EmbryoPhenomics/LabEmbryoCam_V2/software/assets/img/labec_instrument.png

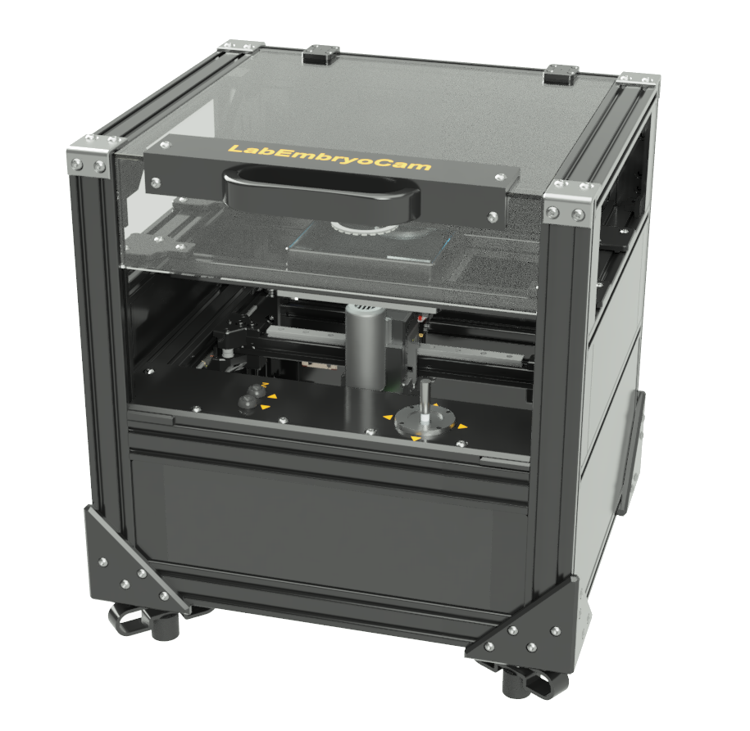
software/assets/img/labec_instrument.png
