EmbryoPhenomics/LabEmbryoCam_V2/hardware/STLs/humidification_chamber_main.stl

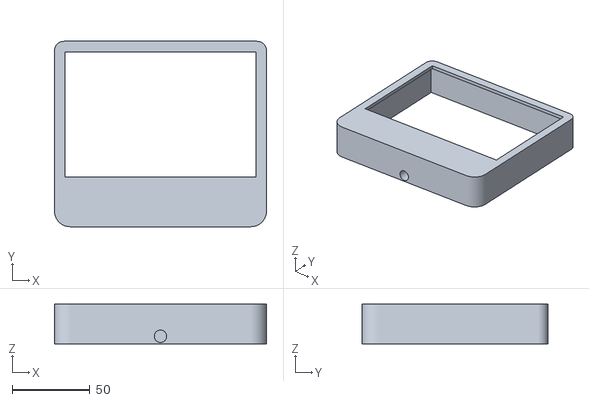
[picture p2: CAD file, 2023-06-20, last stored version]
hardware/STLs/humidification_chamber_main.stl
136.0 x 119.0 x 25.5
