EmbryoPhenomics/LabEmbryoCam_V2/hardware/STLs/z_carriage_assembly_light_insert.stl

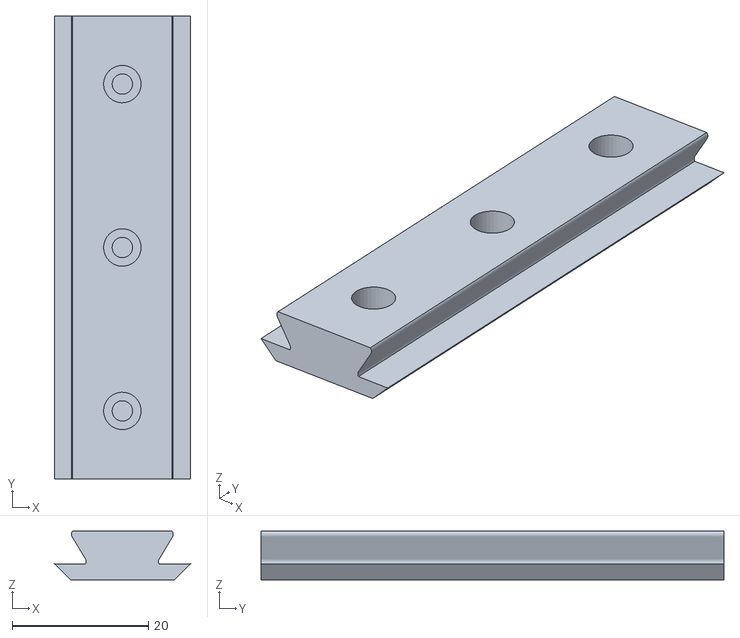
[picture p3: CAD file, 2023-06-20, last stored version]
hardware/STLs/z_carriage_assembly_light_insert.stl
20.0 x 68.0 x 7.16
