EmbryoPhenomics/LabEmbryoCam_V2/hardware/STLs/z_carriage_assembly_camera_tripod_adapter.stl

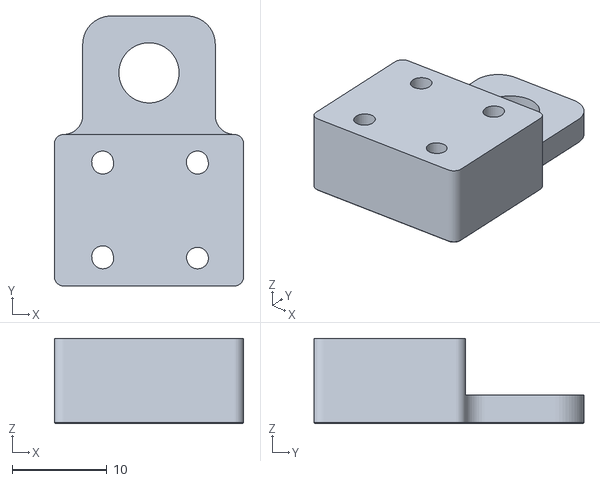
[picture p4: CAD file, 2023-06-20, last stored version]
hardware/STLs/z_carriage_assembly_camera_tripod_adapter.stl
20.0 x 28.5 x 9.00
