EmbryoPhenomics/LabEmbryoCam_V2/hardware/STLs/z_carriage_assembly_camera_mount.stl

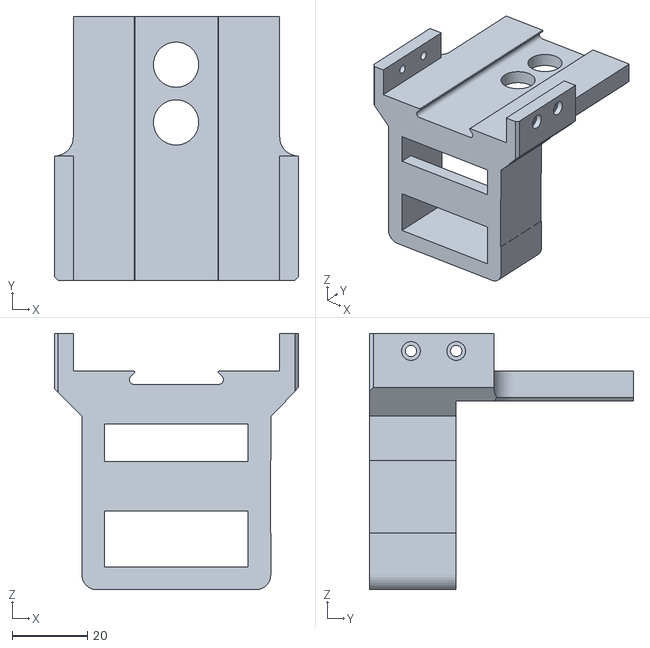
[picture p5: CAD file, 2023-06-20, last stored version]
hardware/STLs/z_carriage_assembly_camera_mount.stl
64.7 x 70.0 x 68.0
