EmbryoPhenomics/LabEmbryoCam_V2/hardware/STLs/z_carriage_assembly_optics_insert.stl

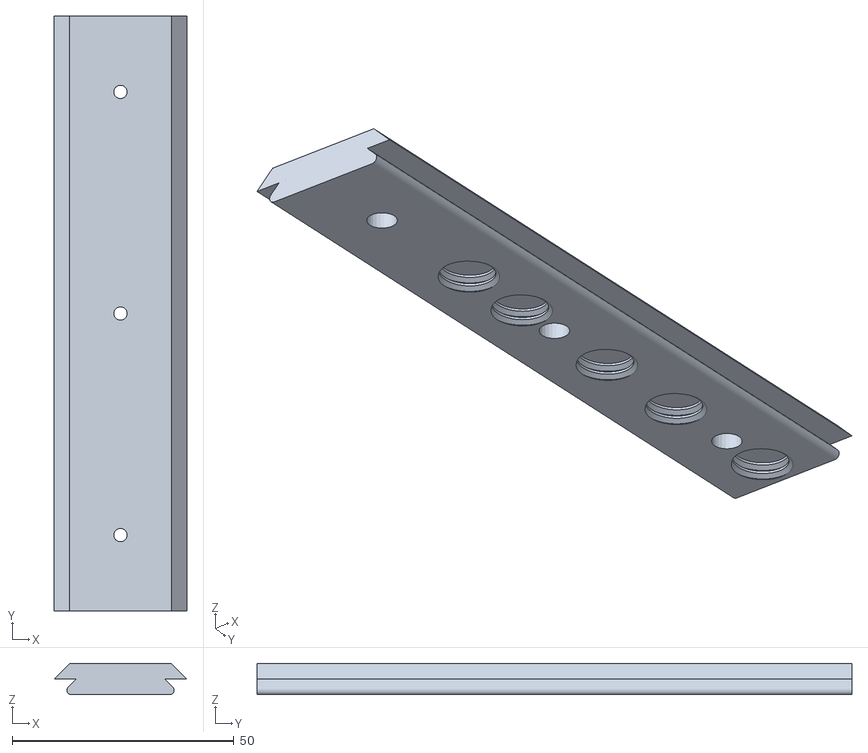
[picture p6: CAD file, 2023-06-20, last stored version]
hardware/STLs/z_carriage_assembly_optics_insert.stl
30.0 x 134.2 x 7.07
