EmbryoPhenomics/LabEmbryoCam_V2/hardware/STLs/back_motion_corner_mainbody_left.stl

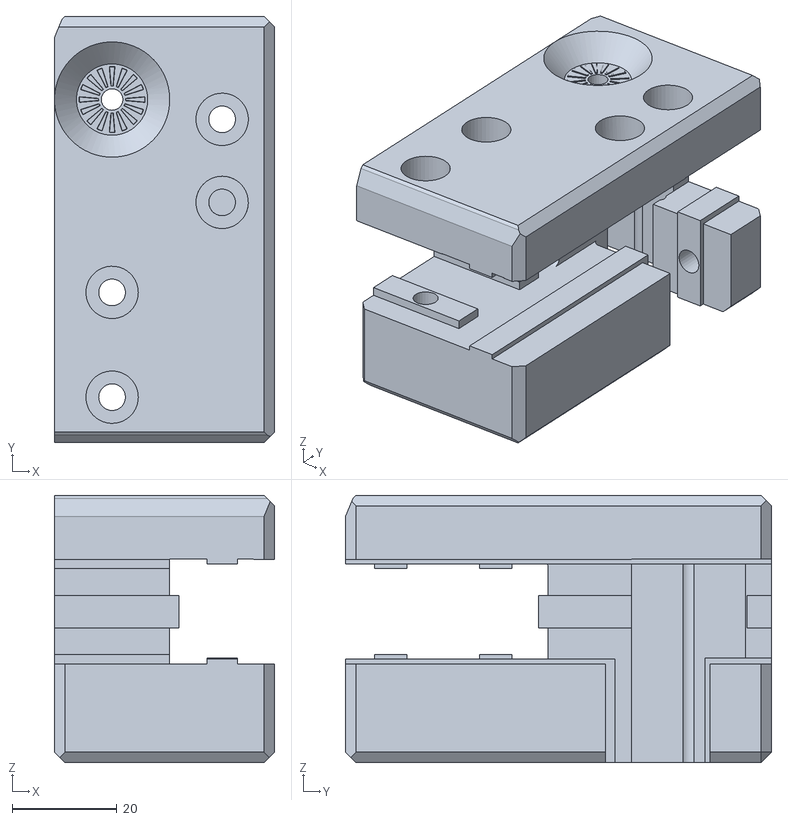
[picture p7: CAD file, 2023-06-20, last stored version]
hardware/STLs/back_motion_corner_mainbody_left.stl
42.0 x 81.3 x 51.0
