EmbryoPhenomics/LabEmbryoCam_V2/hardware/STLs/z_carriage_assembly_limit_trigger.stl

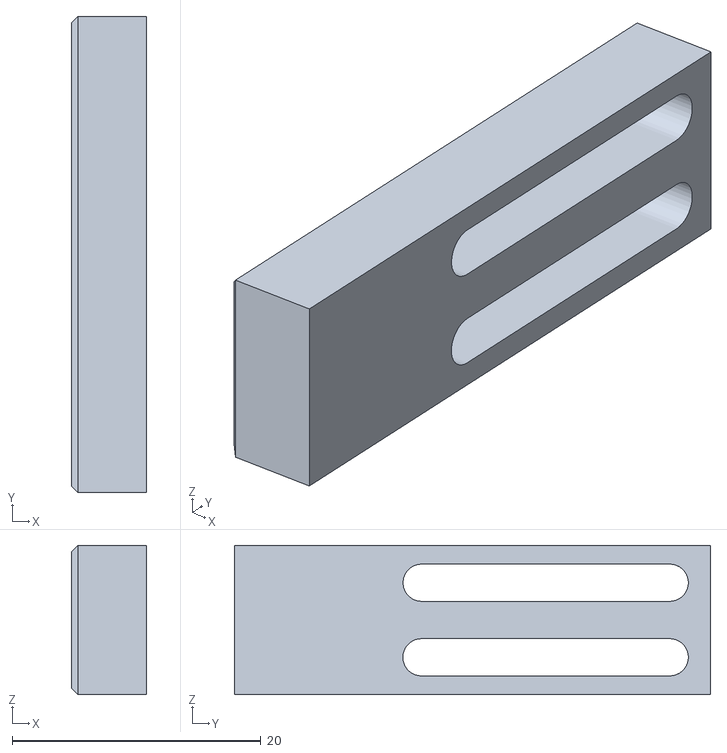
[picture p8: CAD file, 2023-06-20, last stored version]
hardware/STLs/z_carriage_assembly_limit_trigger.stl
6.00 x 38.3 x 12.0
