EmbryoPhenomics/LabEmbryoCam_V2/hardware/STLs/back_motion_corner_mainbody_right.stl

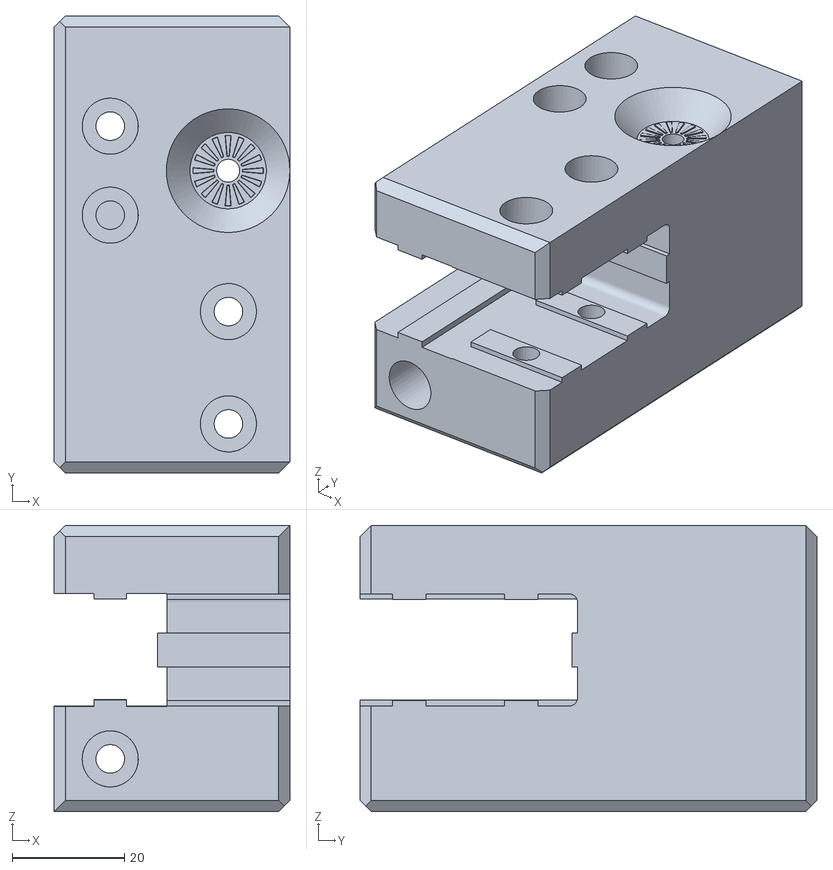
[picture p9: CAD file, 2023-06-20, last stored version]
hardware/STLs/back_motion_corner_mainbody_right.stl
42.0 x 81.4 x 51.0
