EmbryoPhenomics/LabEmbryoCam_V2/hardware/STLs/cable vibration dampener bottom.stl

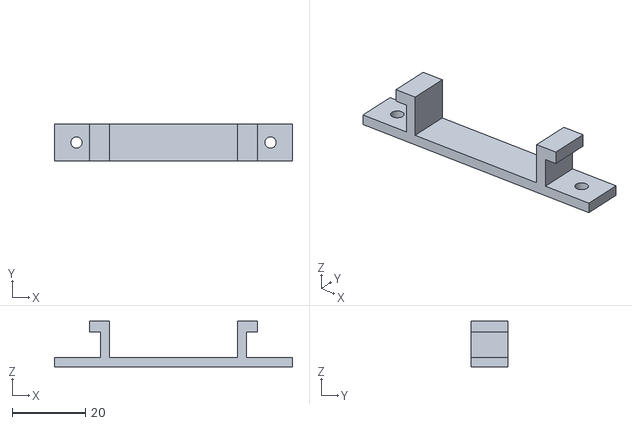
[picture p10: CAD file, 2023-06-20, last stored version]
hardware/STLs/cable vibration dampener bottom.stl
65.0 x 10.0 x 12.5
