EmbryoPhenomics/LabEmbryoCam_V2/hardware/STLs/humidification_chamber_lid.stl

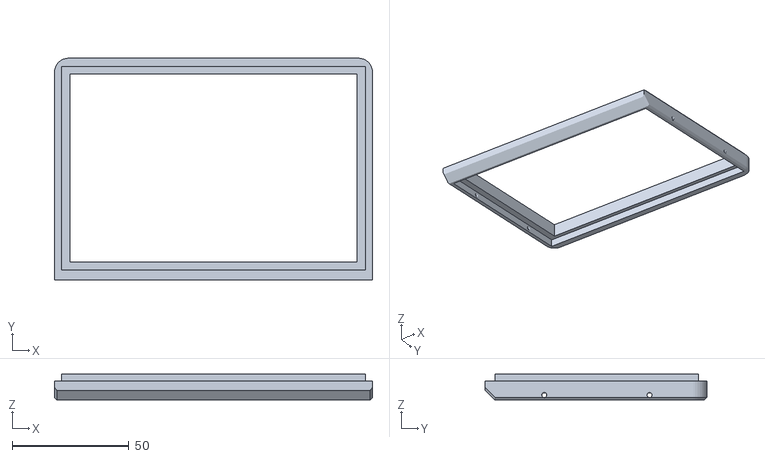
[picture p11: CAD file, 2023-06-20, last stored version]
hardware/STLs/humidification_chamber_lid.stl
136.0 x 94.8 x 11.0
