EmbryoPhenomics/LabEmbryoCam_V2/hardware/STLs/z_carriage_light_carrier.stl

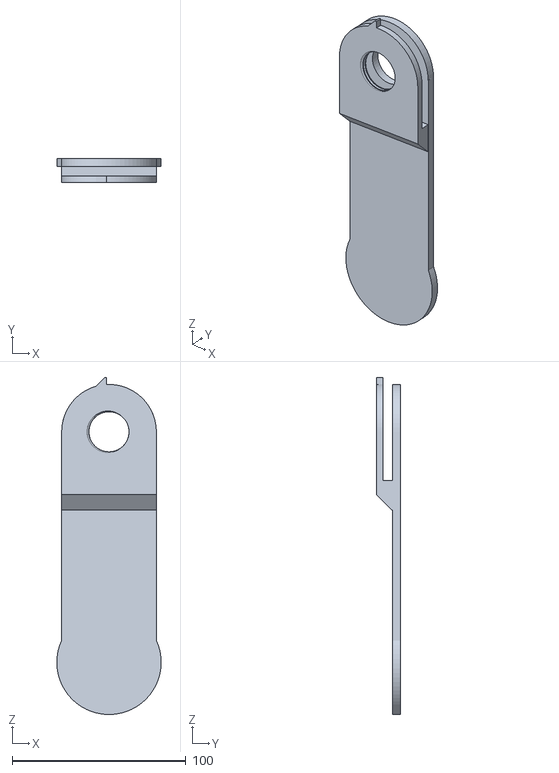
[picture p12: CAD file, 2023-06-20, last stored version]
hardware/STLs/z_carriage_light_carrier.stl
60.0 x 14.0 x 193.7
