EmbryoPhenomics/LabEmbryoCam_V2/hardware/STLs/z_carriage_light_slider.stl

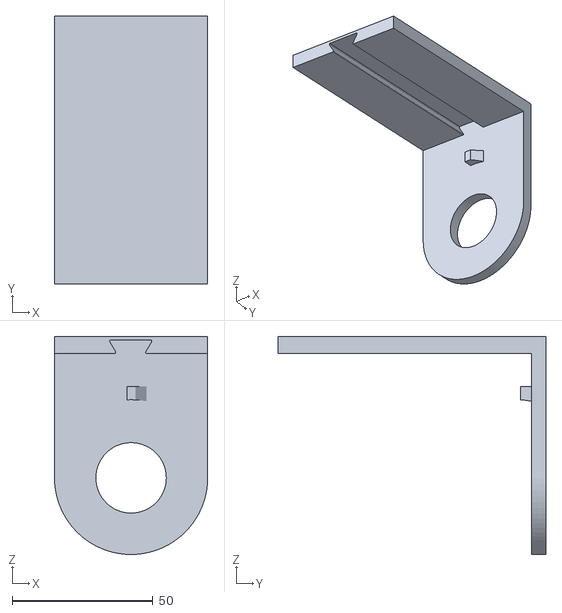
[picture p13: CAD file, 2023-06-20, last stored version]
hardware/STLs/z_carriage_light_slider.stl
54.5 x 95.0 x 77.4
