EmbryoPhenomics/LabEmbryoCam_V2/hardware/STLs/front_corner_left_bottom.stl

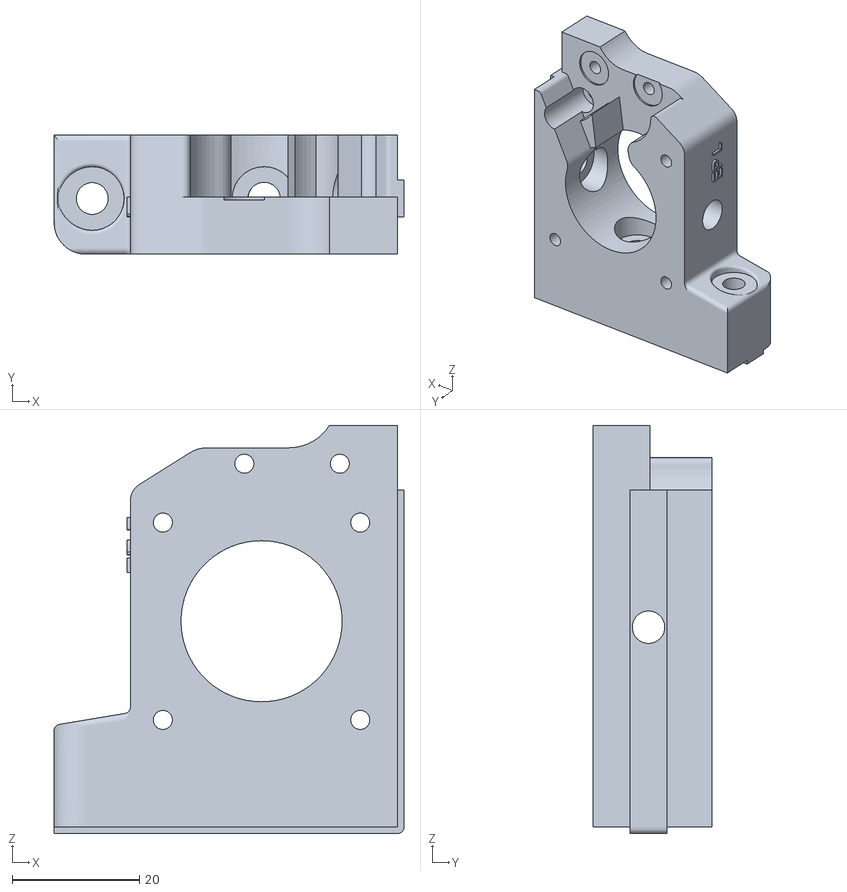
[picture p14: CAD file, 2023-06-20, last stored version]
hardware/STLs/front_corner_left_bottom.stl
55.0 x 18.8 x 64.1
