EmbryoPhenomics/LabEmbryoCam_V2/hardware/STLs/lid_bracket_support(2).stl

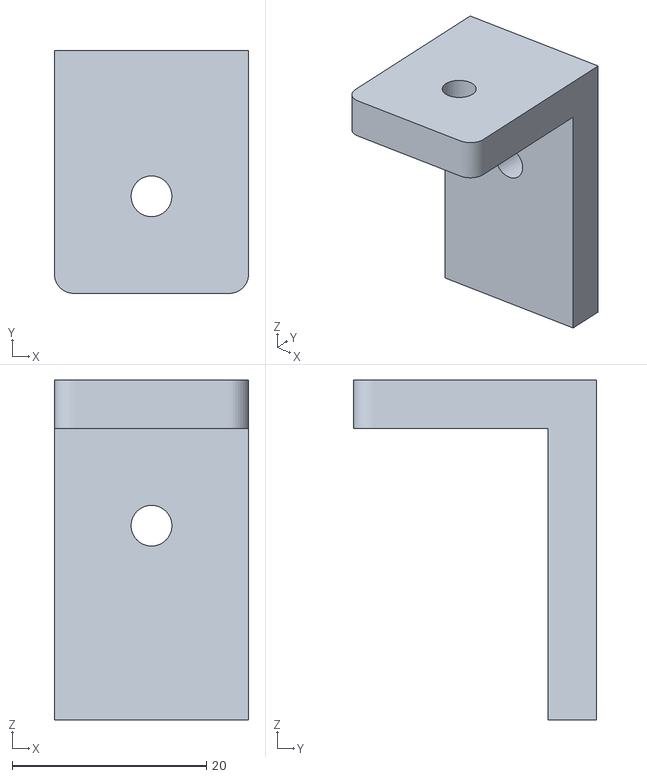
[picture p15: CAD file, 2023-06-20, last stored version]
hardware/STLs/lid_bracket_support(2).stl
20.0 x 25.0 x 35.0
