EmbryoPhenomics/LabEmbryoCam_V2/hardware/STLs/lid_support_bracket_upper.stl

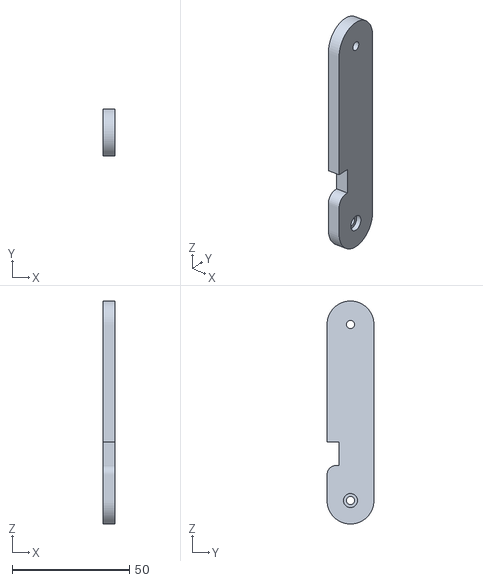
[picture p16: CAD file, 2023-06-20, last stored version]
hardware/STLs/lid_support_bracket_upper.stl
5.00 x 20.0 x 95.0
