EmbryoPhenomics/LabEmbryoCam_V2/hardware/STLs/electronics_minitronics_mounting_bracket.stl

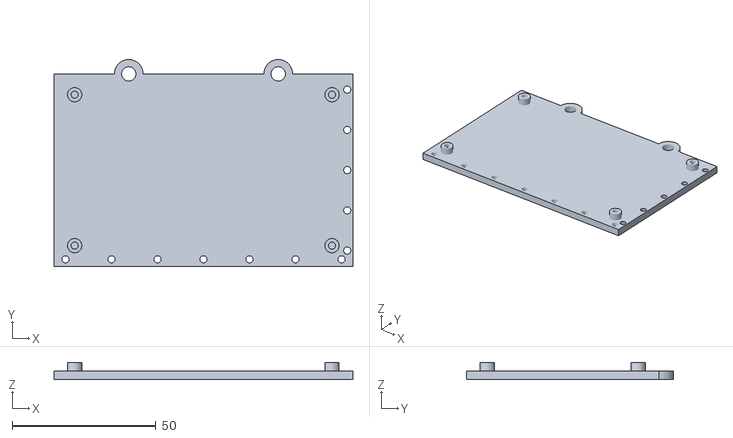
[picture p17: CAD file, 2023-06-20, last stored version]
hardware/STLs/electronics_minitronics_mounting_bracket.stl
104.0 x 72.0 x 6.00
