EmbryoPhenomics/LabEmbryoCam_V2/hardware/STLs/spacers_top_back_left.stl

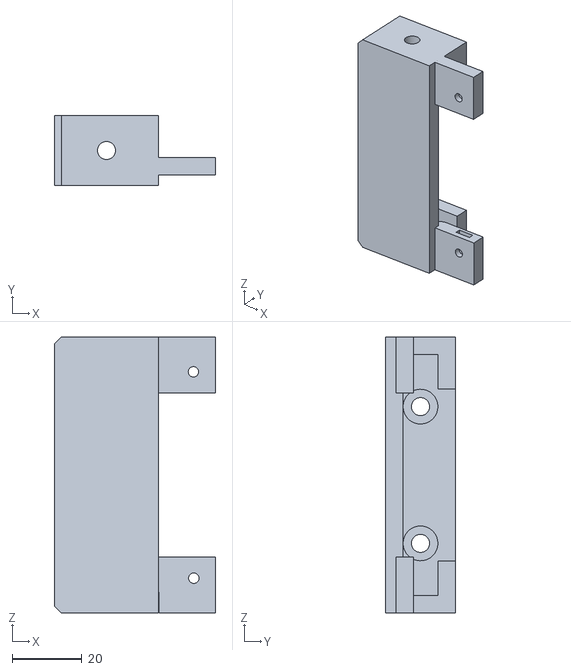
[picture p18: CAD file, 2023-06-20, last stored version]
hardware/STLs/spacers_top_back_left.stl
46.4 x 20.0 x 79.3
