EmbryoPhenomics/LabEmbryoCam_V2/hardware/STLs/y_mount_big_r.stl

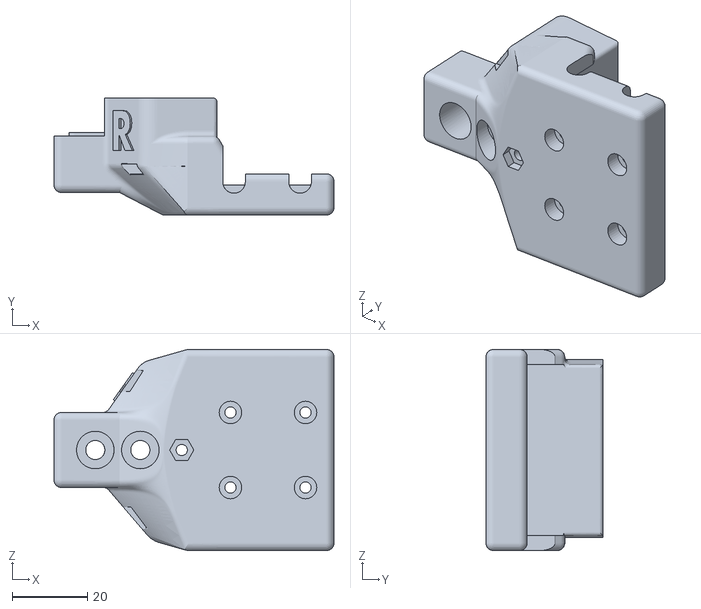
[picture p19: CAD file, 2023-06-20, last stored version]
hardware/STLs/y_mount_big_r.stl
74.6 x 31.2 x 53.6
