EmbryoPhenomics/LabEmbryoCam_V2/hardware/STLs/back_motion_corner_right_smallbody.stl

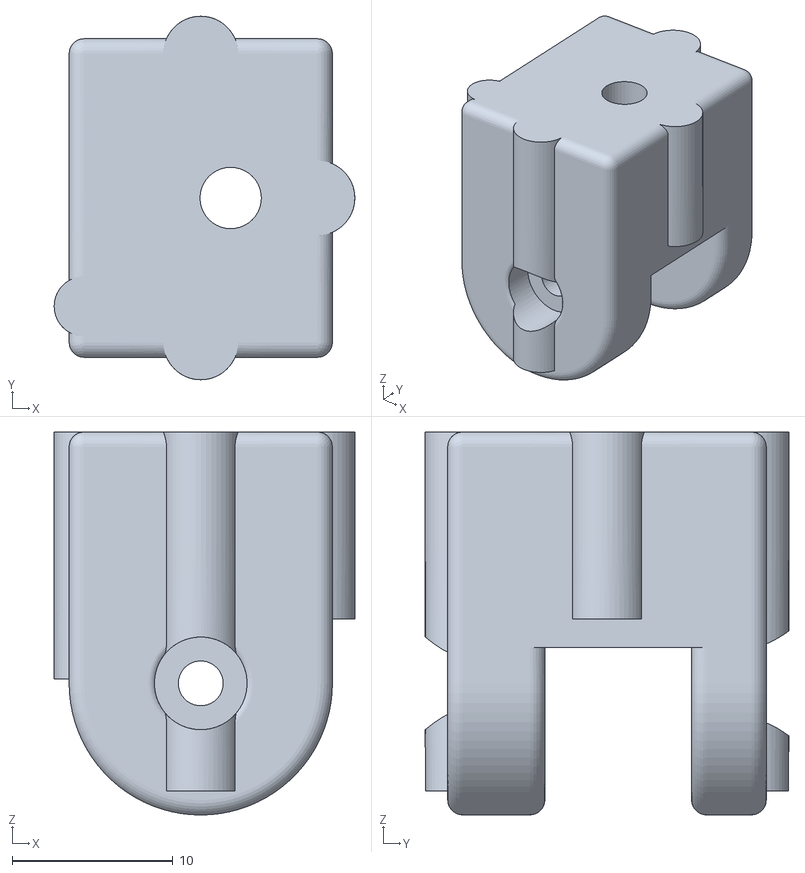
[picture p20: CAD file, 2023-06-20, last stored version]
hardware/STLs/back_motion_corner_right_smallbody.stl
18.7 x 22.6 x 23.8
