EmbryoPhenomics/LabEmbryoCam_V2/hardware/STLs/y_mount_small_r.stl

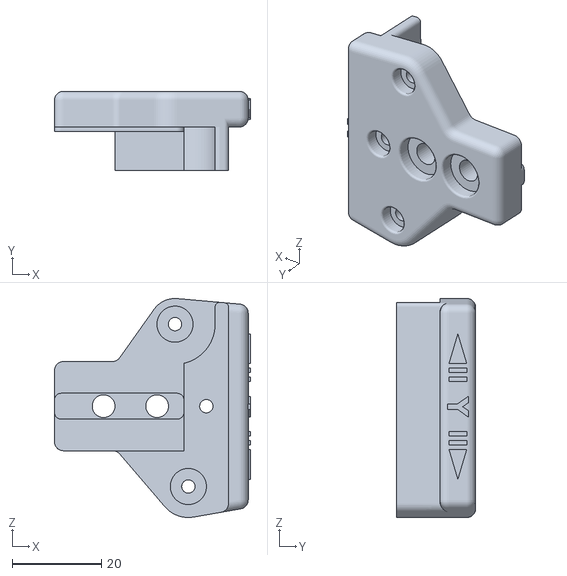
[picture p21: CAD file, 2023-06-20, last stored version]
hardware/STLs/y_mount_small_r.stl
43.9 x 17.8 x 49.1
