EmbryoPhenomics/LabEmbryoCam_V2/hardware/STLs/top_corner.stl

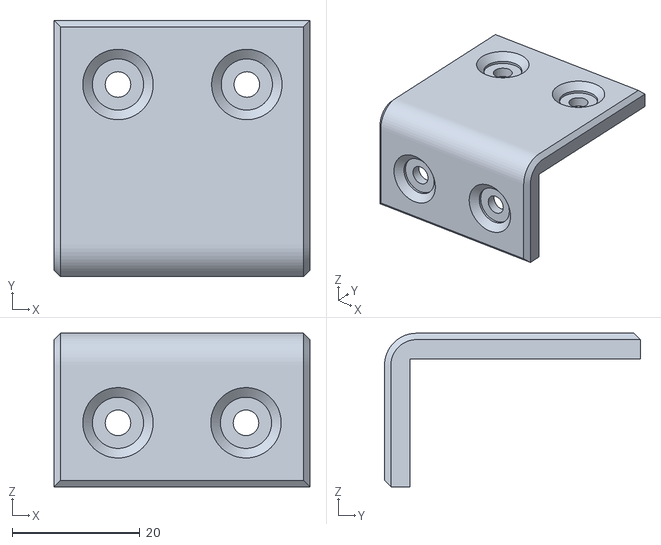
[picture p22: CAD file, 2023-06-20, last stored version]
hardware/STLs/top_corner.stl
40.0 x 40.0 x 24.0
