EmbryoPhenomics/LabEmbryoCam_V2/hardware/STLs/humidification_chamber_mount.stl

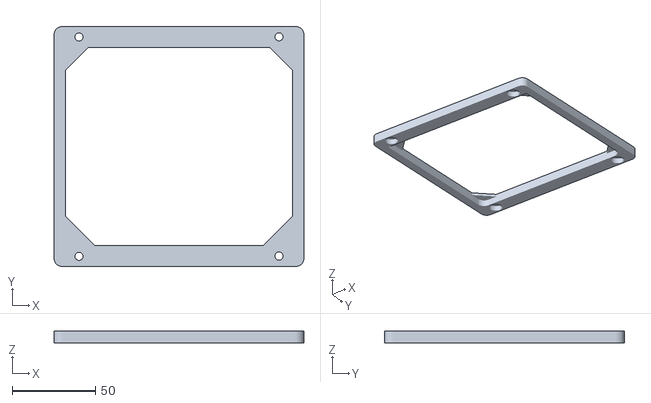
[picture p23: CAD file, 2023-06-20, last stored version]
hardware/STLs/humidification_chamber_mount.stl
150.0 x 144.0 x 7.00
