EmbryoPhenomics/LabEmbryoCam_V2/hardware/STLs/spacers_bottom_side_back_right.stl

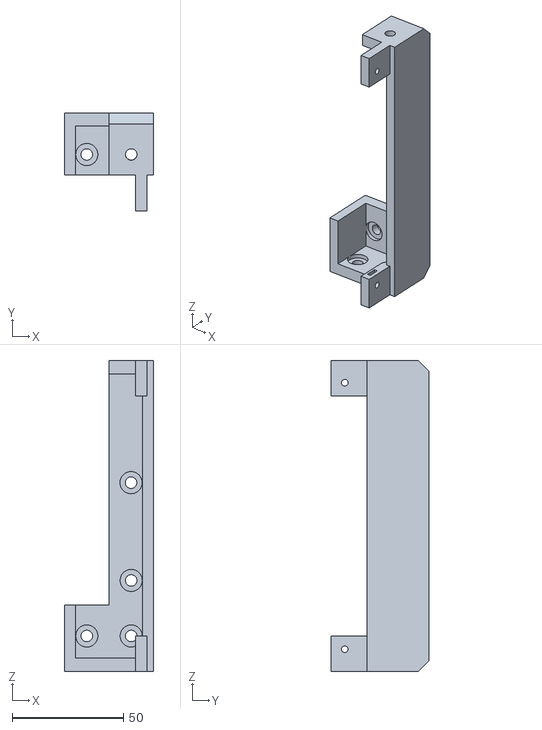
[picture p24: CAD file, 2023-06-20, last stored version]
hardware/STLs/spacers_bottom_side_back_right.stl
40.0 x 44.3 x 140.0
