EmbryoPhenomics/LabEmbryoCam_V2/hardware/STLs/front_corner_left_top.stl

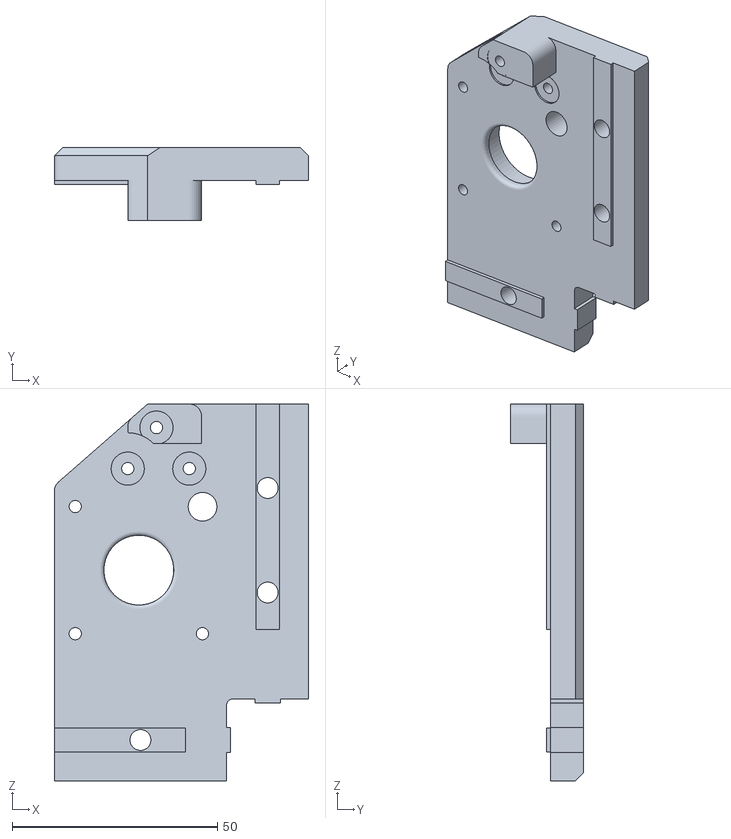
[picture p25: CAD file, 2023-06-20, last stored version]
hardware/STLs/front_corner_left_top.stl
62.0 x 17.8 x 91.9
