EmbryoPhenomics/LabEmbryoCam_V2/hardware/STLs/electronics_atx_power_mount.stl

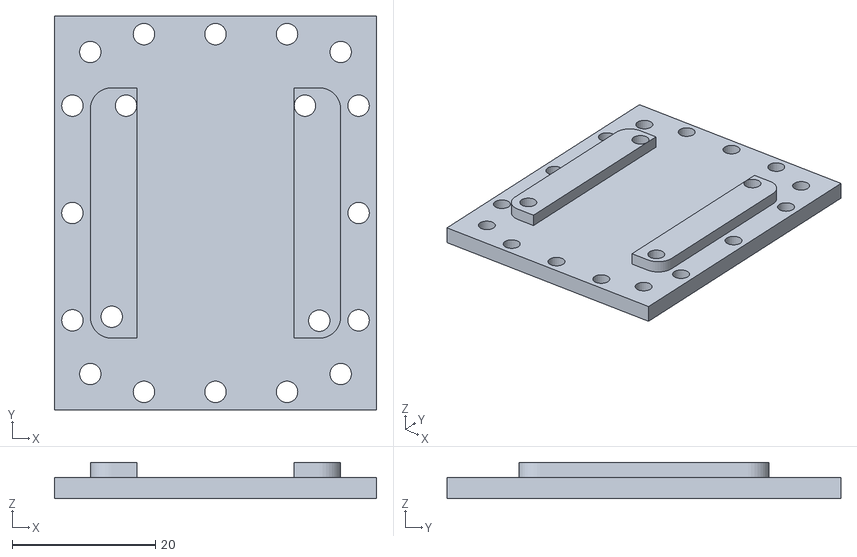
[picture p26: CAD file, 2023-06-20, last stored version]
hardware/STLs/electronics_atx_power_mount.stl
45.0 x 55.0 x 5.10
