EmbryoPhenomics/LabEmbryoCam_V2/hardware/STLs/lid_bracket.stl

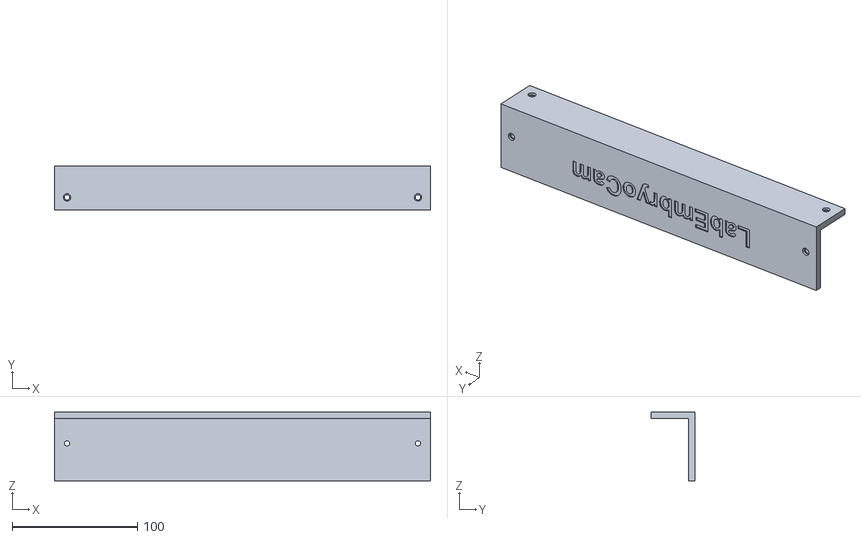
[picture p27: CAD file, 2023-06-20, last stored version]
hardware/STLs/lid_bracket.stl
300.0 x 35.0 x 55.0
