EmbryoPhenomics/LabEmbryoCam_V2/hardware/STLs/joystick_panel_right_Z_arrows.stl

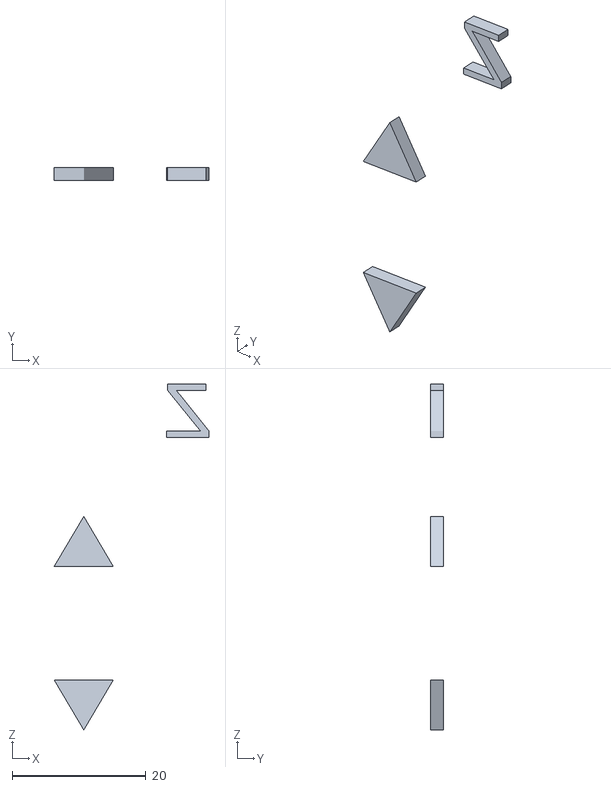
[picture p28: CAD file, 2023-06-20, last stored version]
hardware/STLs/joystick_panel_right_Z_arrows.stl
23.2 x 2.00 x 51.7
