EmbryoPhenomics/LabEmbryoCam_V2/hardware/STLs/spacers_bottom_back_right.stl

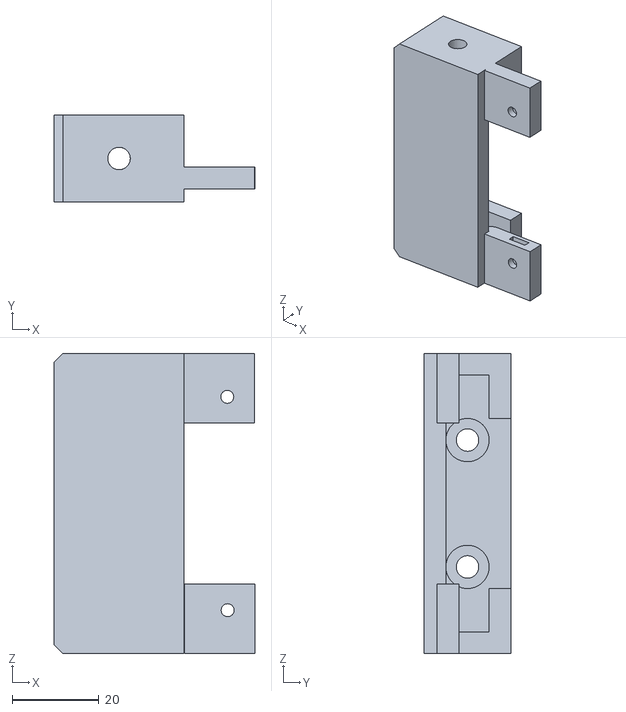
[picture p29: CAD file, 2023-06-20, last stored version]
hardware/STLs/spacers_bottom_back_right.stl
46.4 x 20.0 x 69.3
