EmbryoPhenomics/LabEmbryoCam_V2/hardware/STLs/back_corner_knob(2).stl

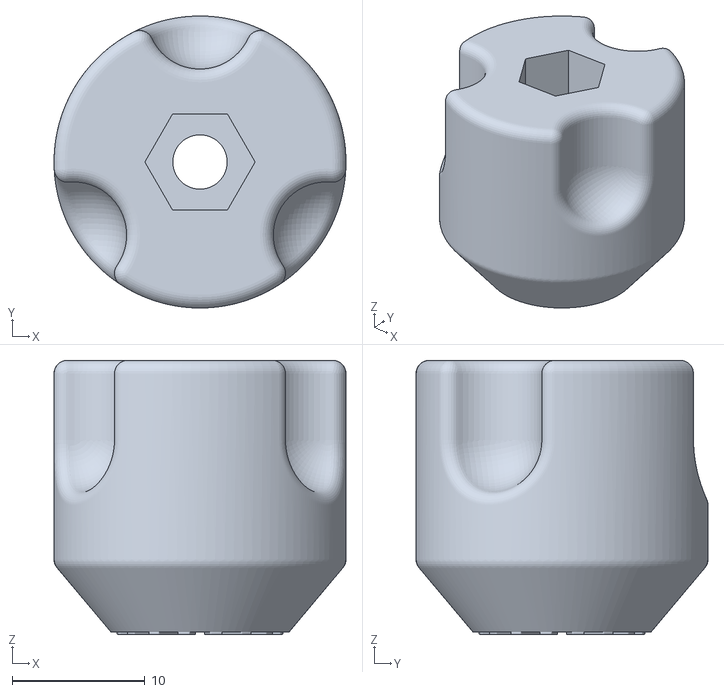
[picture p30: CAD file, 2023-06-20, last stored version]
hardware/STLs/back_corner_knob(2).stl
22.0 x 22.0 x 20.7
