EmbryoPhenomics/LabEmbryoCam_V2/hardware/STLs/sample_holder_bracket(4).stl

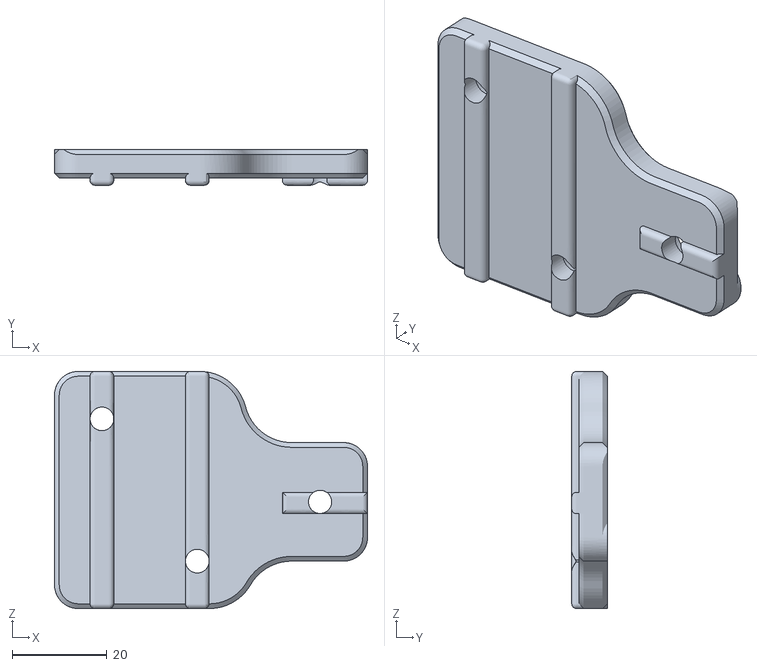
[picture p31: CAD file, 2023-06-20, last stored version]
hardware/STLs/sample_holder_bracket(4).stl
66.0 x 7.50 x 50.0
