EmbryoPhenomics/LabEmbryoCam_V2/hardware/STLs/electronics_minitronics_fan fan_support(mirror)(2).stl

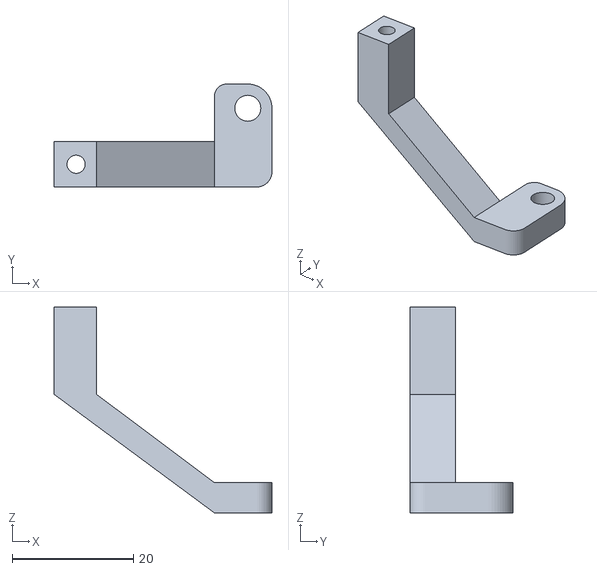
[picture p32: CAD file, 2023-06-20, last stored version]
hardware/STLs/electronics_minitronics_fan fan_support(mirror)(2).stl
36.0 x 17.0 x 34.0
