EmbryoPhenomics/LabEmbryoCam_V2/hardware/STLs/bottom_corner_bracket_mirror(2).stl

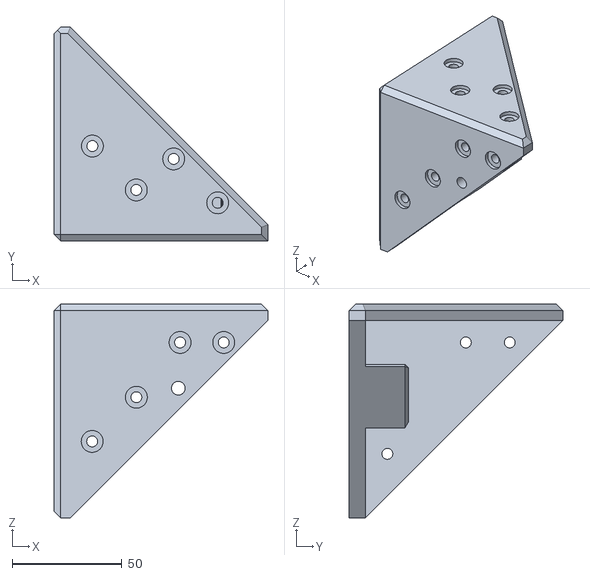
[picture p33: CAD file, 2023-06-20, last stored version]
hardware/STLs/bottom_corner_bracket_mirror(2).stl
97.5 x 97.5 x 97.5
