EmbryoPhenomics/LabEmbryoCam_V2/hardware/STLs/spacers_back_mid(2).stl

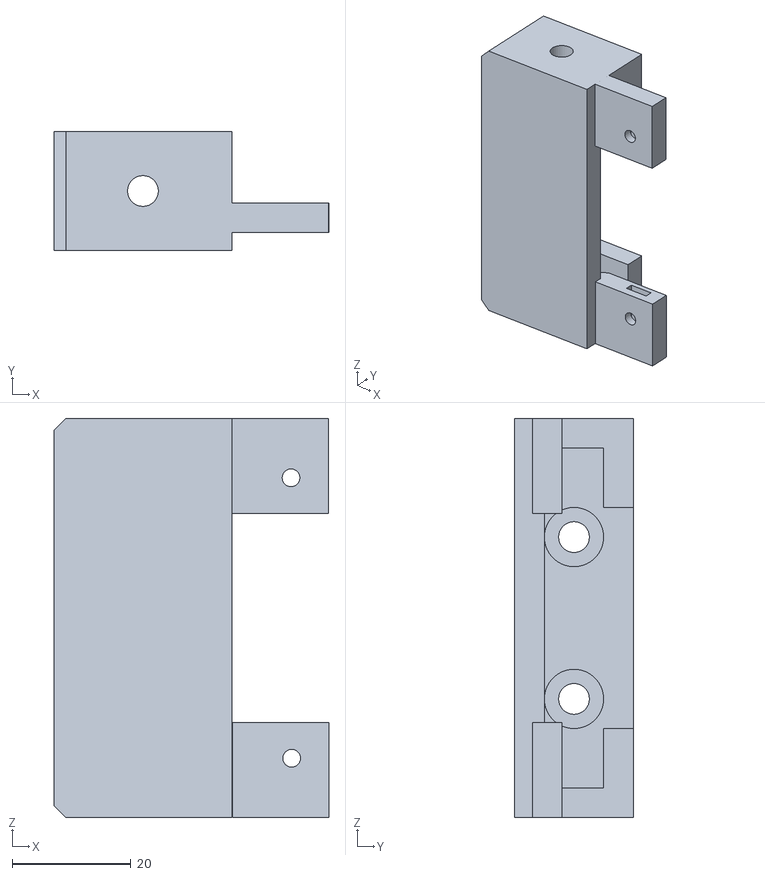
[picture p34: CAD file, 2023-06-20, last stored version]
hardware/STLs/spacers_back_mid(2).stl
46.4 x 20.0 x 67.3
