EmbryoPhenomics/LabEmbryoCam_V2/hardware/STLs/spacers_front_bottom_right.stl

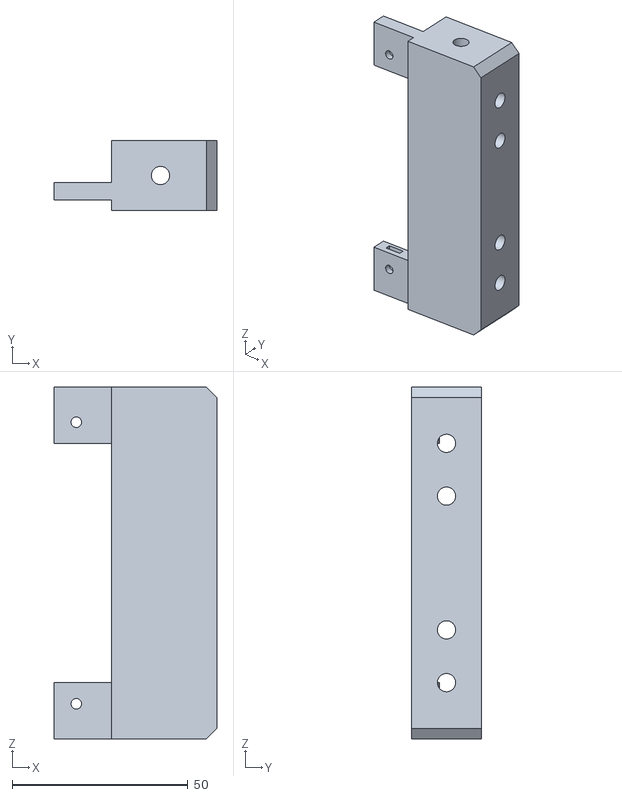
[picture p35: CAD file, 2023-06-20, last stored version]
hardware/STLs/spacers_front_bottom_right.stl
46.2 x 20.0 x 100.0
