EmbryoPhenomics/LabEmbryoCam_V2/hardware/STLs/spacers_mid_and_top_bracket(4).stl

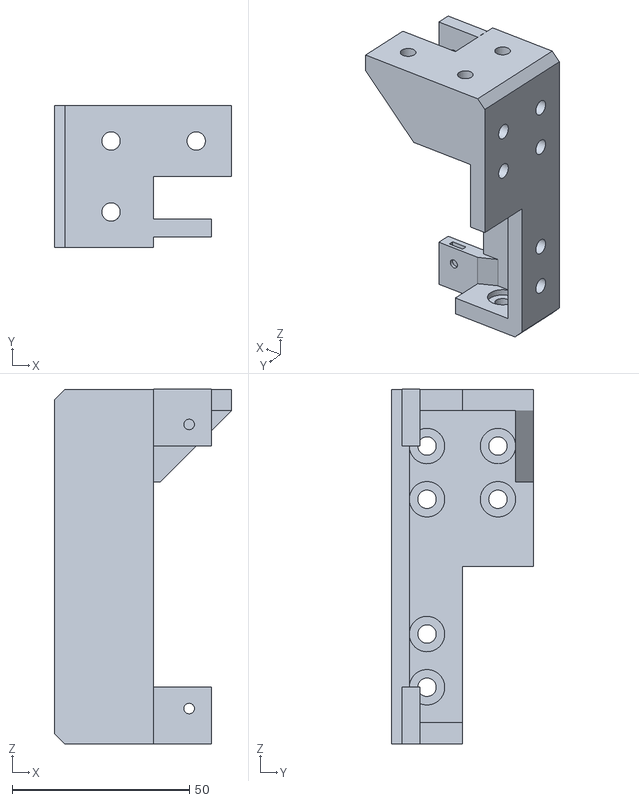
[picture p36: CAD file, 2023-06-20, last stored version]
hardware/STLs/spacers_mid_and_top_bracket(4).stl
50.0 x 40.0 x 100.1
