EmbryoPhenomics/LabEmbryoCam_V2/hardware/STLs/joystick_panel_left.stl

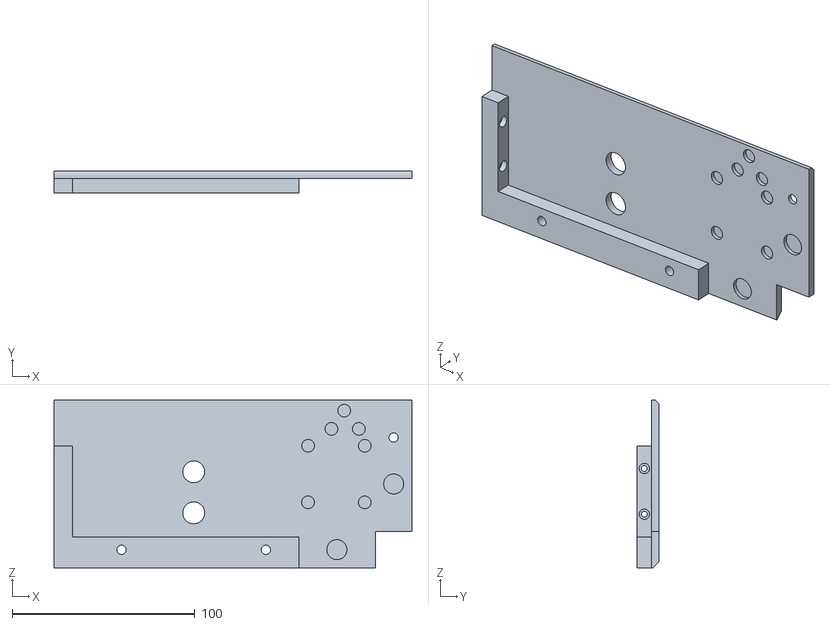
[picture p37: CAD file, 2023-06-20, last stored version]
hardware/STLs/joystick_panel_left.stl
196.0 x 12.0 x 92.0
