EmbryoPhenomics/LabEmbryoCam_V2/hardware/STLs/front_corner_left_bottom_small.stl

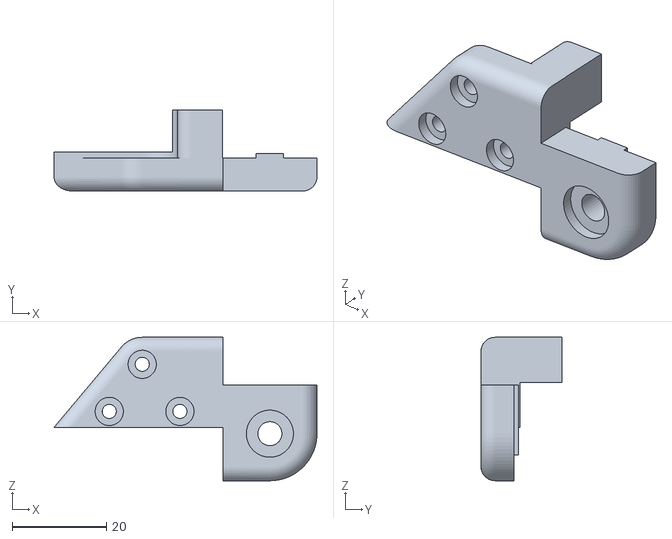
[picture p38: CAD file, 2023-06-20, last stored version]
hardware/STLs/front_corner_left_bottom_small.stl
55.8 x 17.2 x 30.5
