EmbryoPhenomics/LabEmbryoCam_V2/hardware/STLs/electronics_raspberry_pi_mount.stl

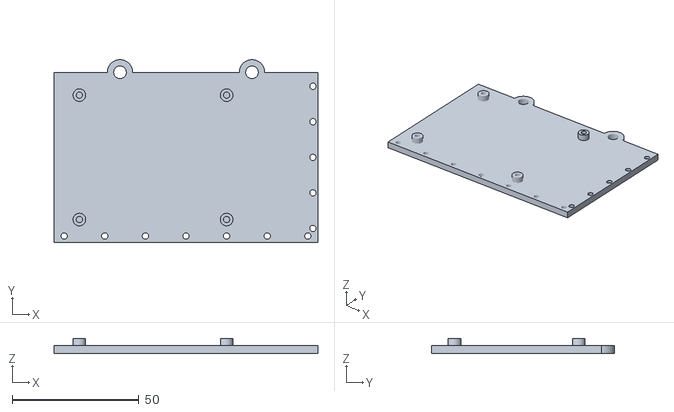
[picture p39: CAD file, 2023-06-20, last stored version]
hardware/STLs/electronics_raspberry_pi_mount.stl
104.0 x 72.0 x 5.79
