EmbryoPhenomics/LabEmbryoCam_V2/hardware/STLs/joystick_panel_left_XY_arrows.stl

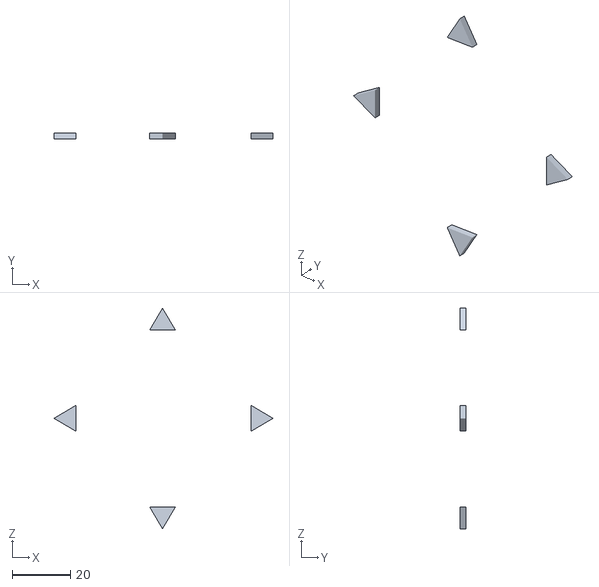
[picture p40: CAD file, 2023-06-20, last stored version]
hardware/STLs/joystick_panel_left_XY_arrows.stl
75.1 x 2.00 x 75.7
