EmbryoPhenomics/LabEmbryoCam_V2/hardware/STLs/z_carriage_rail_mount_insert.stl

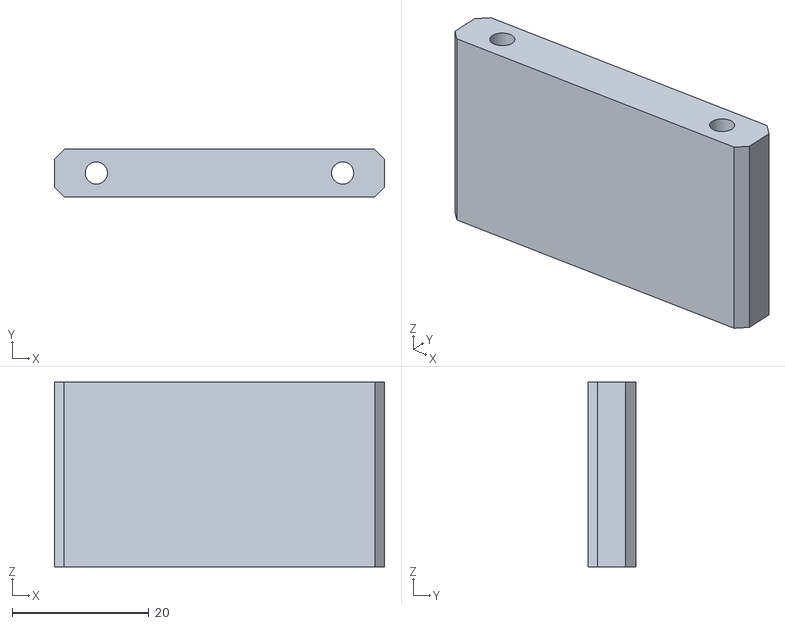
[picture p41: CAD file, 2023-06-20, last stored version]
hardware/STLs/z_carriage_rail_mount_insert.stl
48.2 x 7.00 x 27.0
