EmbryoPhenomics/LabEmbryoCam_V2/hardware/STLs/feet_leafspring(4).stl

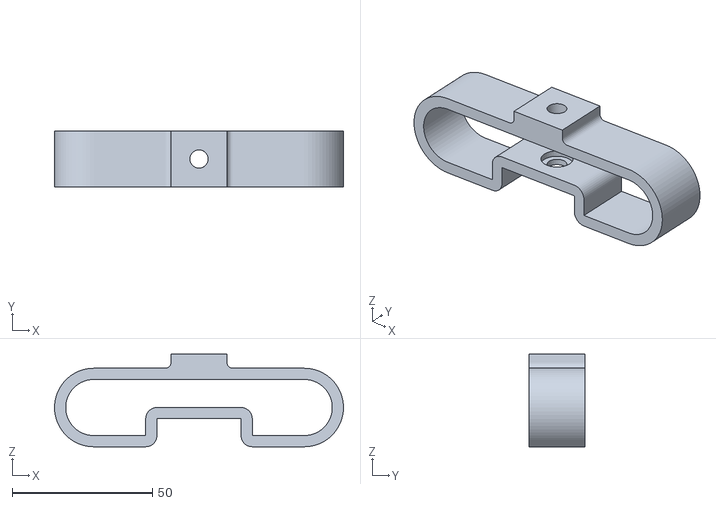
[picture p42: CAD file, 2023-06-20, last stored version]
hardware/STLs/feet_leafspring(4).stl
103.0 x 20.0 x 33.0
