EmbryoPhenomics/LabEmbryoCam_V2/hardware/STLs/lid_bracket_text.stl

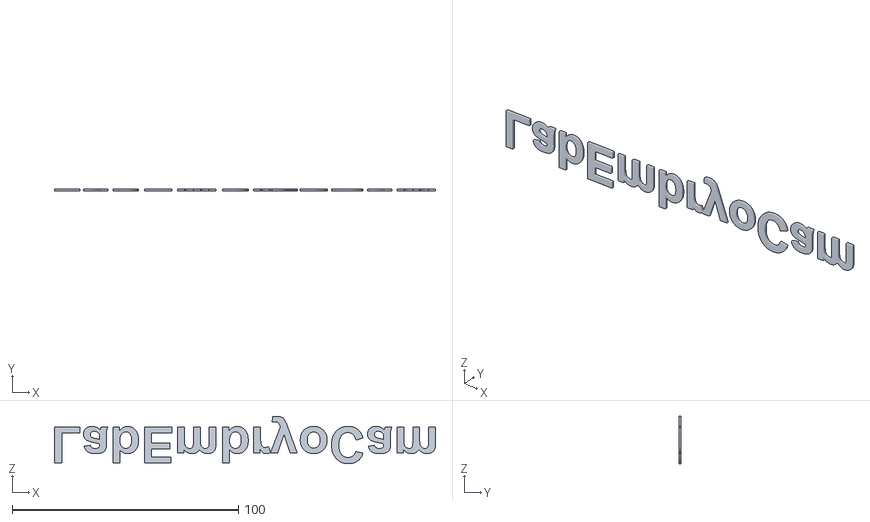
[picture p43: CAD file, 2023-06-20, last stored version]
hardware/STLs/lid_bracket_text.stl
168.2 x 1.00 x 21.0
