EmbryoPhenomics/LabEmbryoCam_V2/hardware/STLs/lid_support_bracket_pivot(2).stl

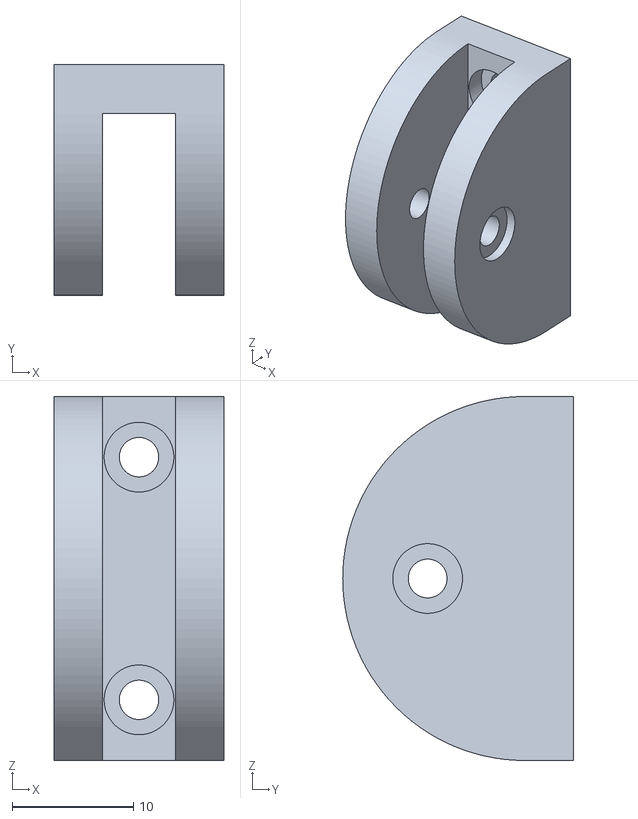
[picture p44: CAD file, 2023-06-20, last stored version]
hardware/STLs/lid_support_bracket_pivot(2).stl
14.0 x 19.0 x 30.0
