EmbryoPhenomics/LabEmbryoCam_V2/hardware/STLs/front_corner_right_top.stl

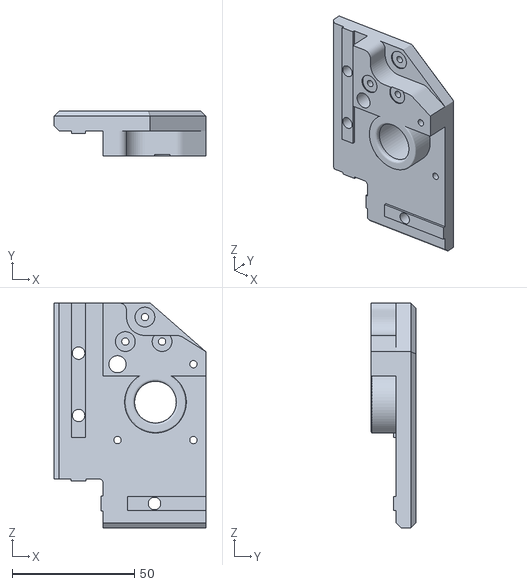
[picture p45: CAD file, 2023-06-20, last stored version]
hardware/STLs/front_corner_right_top.stl
62.0 x 18.2 x 91.9
