EmbryoPhenomics/LabEmbryoCam_V2/hardware/STLs/lid_handle.stl

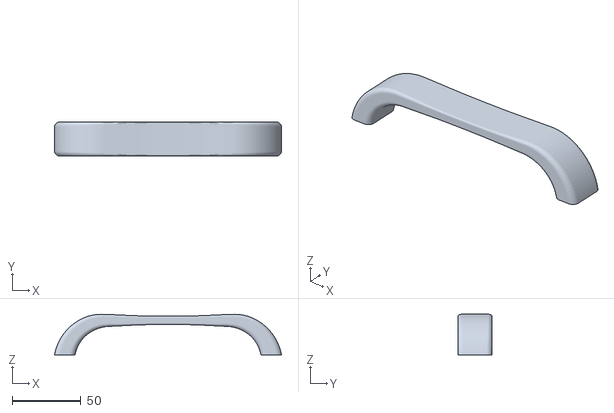
[picture p46: CAD file, 2023-06-20, last stored version]
hardware/STLs/lid_handle.stl
165.0 x 25.0 x 29.4
