EmbryoPhenomics/LabEmbryoCam_V2/hardware/STLs/z_carriage_rail_mount.stl

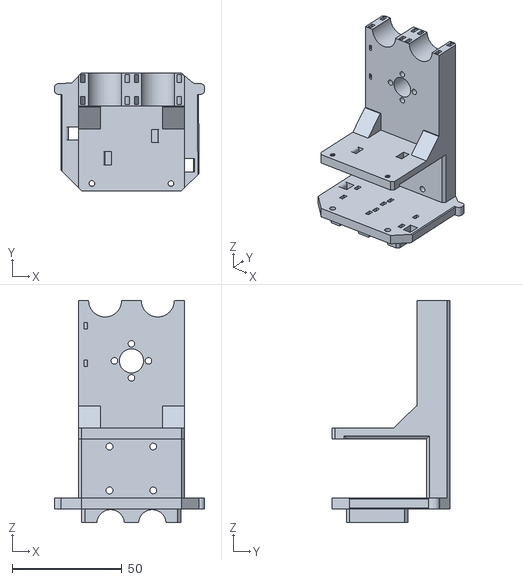
[picture p47: CAD file, 2023-06-20, last stored version]
hardware/STLs/z_carriage_rail_mount.stl
68.5 x 53.8 x 101.1
