EmbryoPhenomics/LabEmbryoCam_V2/hardware/STLs/electronics_dual_arduino_mount_extended.stl

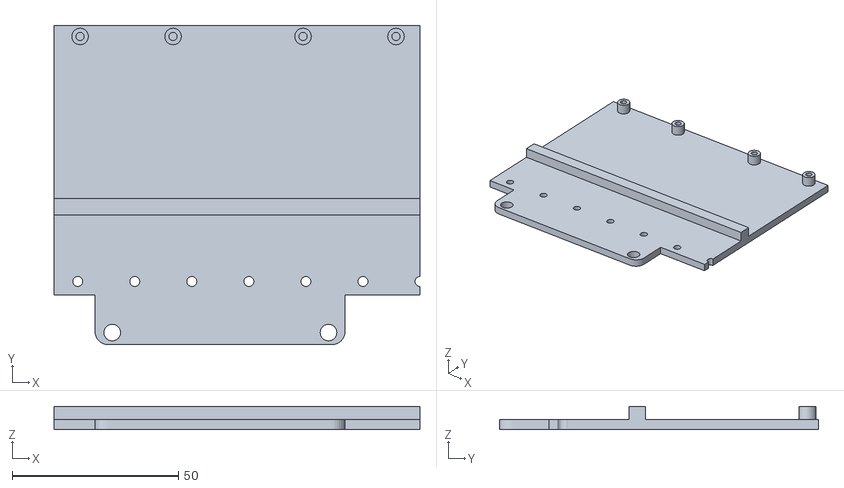
[picture p48: CAD file, 2023-06-20, last stored version]
hardware/STLs/electronics_dual_arduino_mount_extended.stl
110.0 x 96.0 x 7.00
