EmbryoPhenomics/LabEmbryoCam_V2/hardware/STLs/front_corner_right_bottom.stl

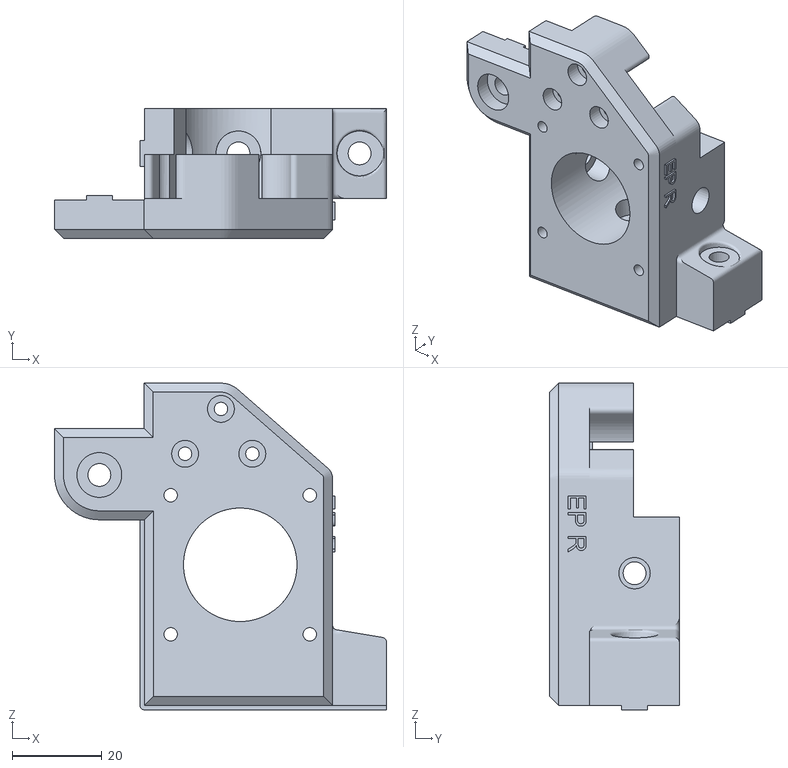
[picture p49: CAD file, 2023-06-20, last stored version]
hardware/STLs/front_corner_right_bottom.stl
74.0 x 29.0 x 72.8
