EmbryoPhenomics/LabEmbryoCam_V2/hardware/STLs/lid_support_bracket_lower.stl

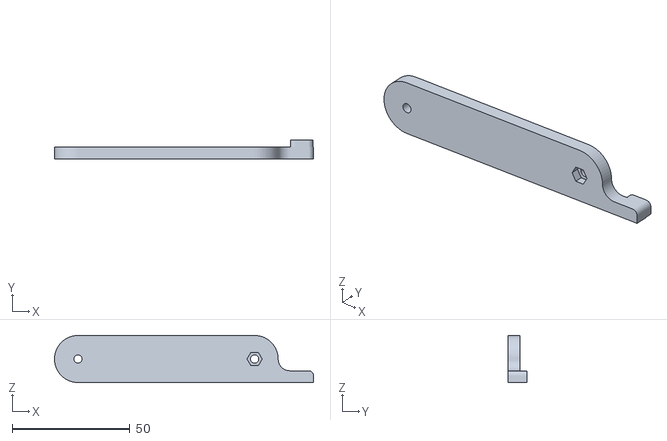
[picture p50: CAD file, 2023-06-20, last stored version]
hardware/STLs/lid_support_bracket_lower.stl
110.0 x 8.00 x 20.0
