EmbryoPhenomics/LabEmbryoCam_V2/hardware/STLs/bottom_corner_bracket(2).stl

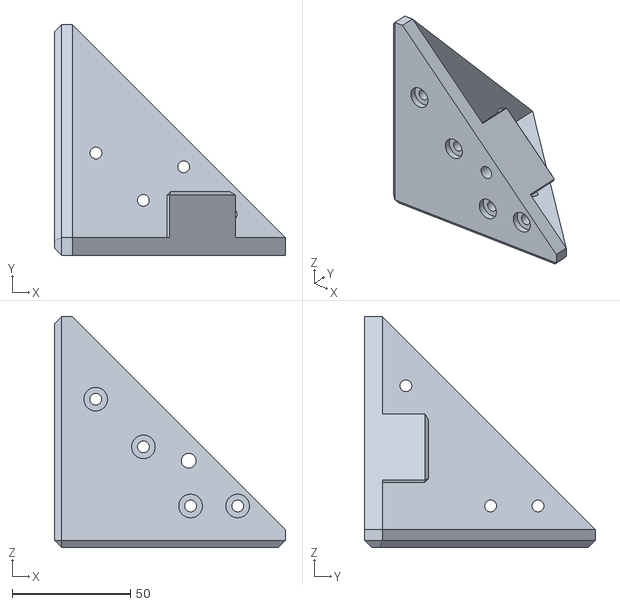
[picture p51: CAD file, 2023-06-20, last stored version]
hardware/STLs/bottom_corner_bracket(2).stl
97.5 x 97.5 x 97.5
