EmbryoPhenomics/LabEmbryoCam_V2/hardware/STLs/back_motion_corner_left_smallbody.stl

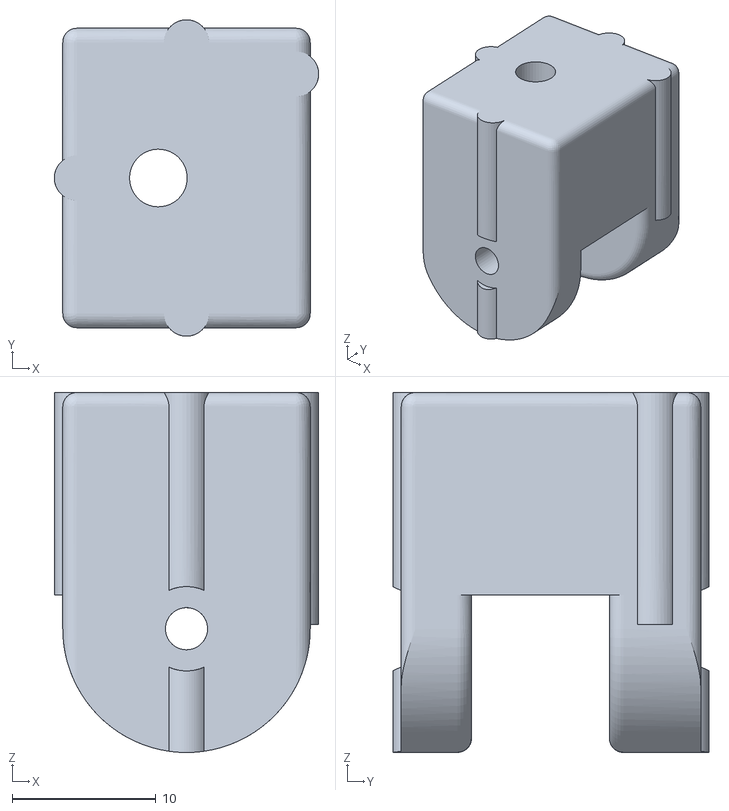
[picture p52: CAD file, 2023-06-20, last stored version]
hardware/STLs/back_motion_corner_left_smallbody.stl
18.4 x 22.1 x 25.1
