EmbryoPhenomics/LabEmbryoCam_V2/hardware/STLs/y_mount_r_limit_switch_holder.stl

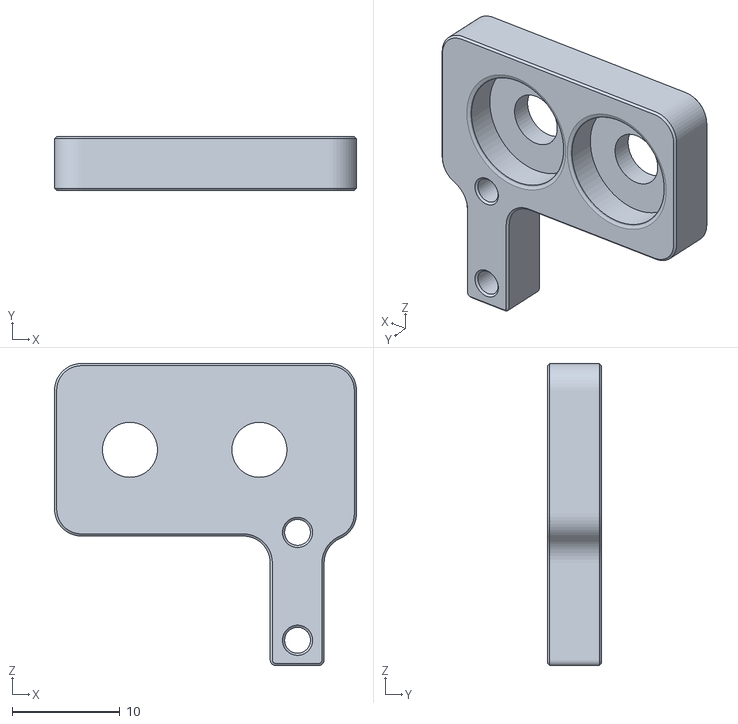
[picture p53: CAD file, 2023-06-20, last stored version]
hardware/STLs/y_mount_r_limit_switch_holder.stl
28.0 x 5.00 x 28.0
