EmbryoPhenomics/LabEmbryoCam_V2/hardware/STLs/electronics_SSD_mount.stl

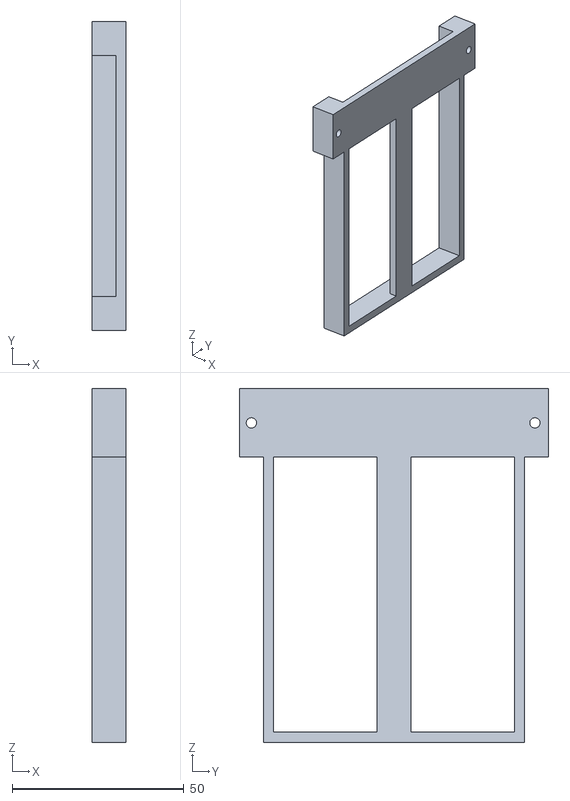
[picture p54: CAD file, 2023-06-20, last stored version]
hardware/STLs/electronics_SSD_mount.stl
10.0 x 90.0 x 103.0
