EmbryoPhenomics/LabEmbryoCam_V2/hardware/STLs/y_mount_small_l.stl

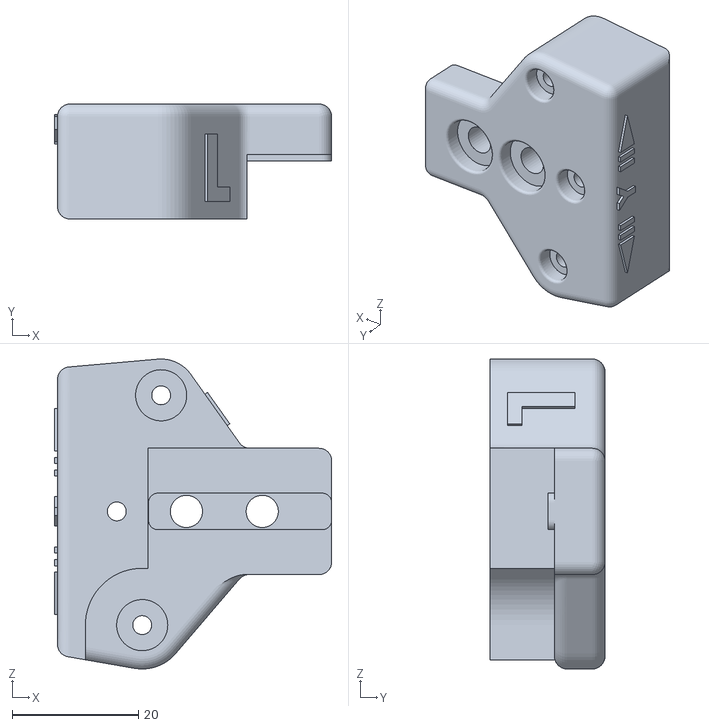
[picture p55: CAD file, 2023-06-20, last stored version]
hardware/STLs/y_mount_small_l.stl
43.9 x 18.2 x 49.1
