EmbryoPhenomics/LabEmbryoCam_V2/hardware/STLs/cable vibration_dampener top.stl

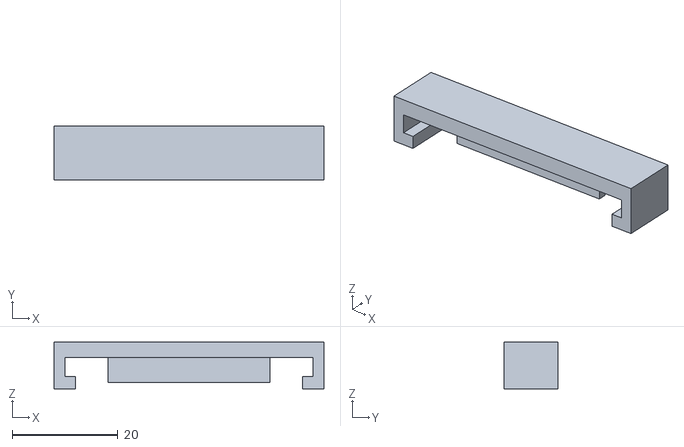
[picture p56: CAD file, 2023-06-20, last stored version]
hardware/STLs/cable vibration_dampener top.stl
51.0 x 10.2 x 8.80
