EmbryoPhenomics/LabEmbryoCam_V2/(list of files, cad)

Other CAD files:
hardware/STLs/spacers_top_back_right.stl
hardware/STLs/spacers_bottom_side_back_left.stl
hardware/STLs/spacers_bottom_side.stl
hardware/STLs/electronics_minitronics_fan support(2).stl
hardware/STLs/spacers_mid_and_top_bracket_anti(4).stl
hardware/STLs/y_mount_big_l.stl
hardware/STLs/joystick_panel_right.stl
hardware/STLs/spacers_front_bottom_left.stl
hardware/STLs/z_carriage_assembly_light_bolt_0.97.stl
hardware/STLs/z_carriage_assembly_rod_screw(4).stl
hardware/STLs/z_carriage_light_screw.stl
hardware/STLs/z_carriage_optics_screw.stl
