EmbryoPhenomics/LabEmbryoCam_V2/documentation/user_guide/assets/xyz-pos.png

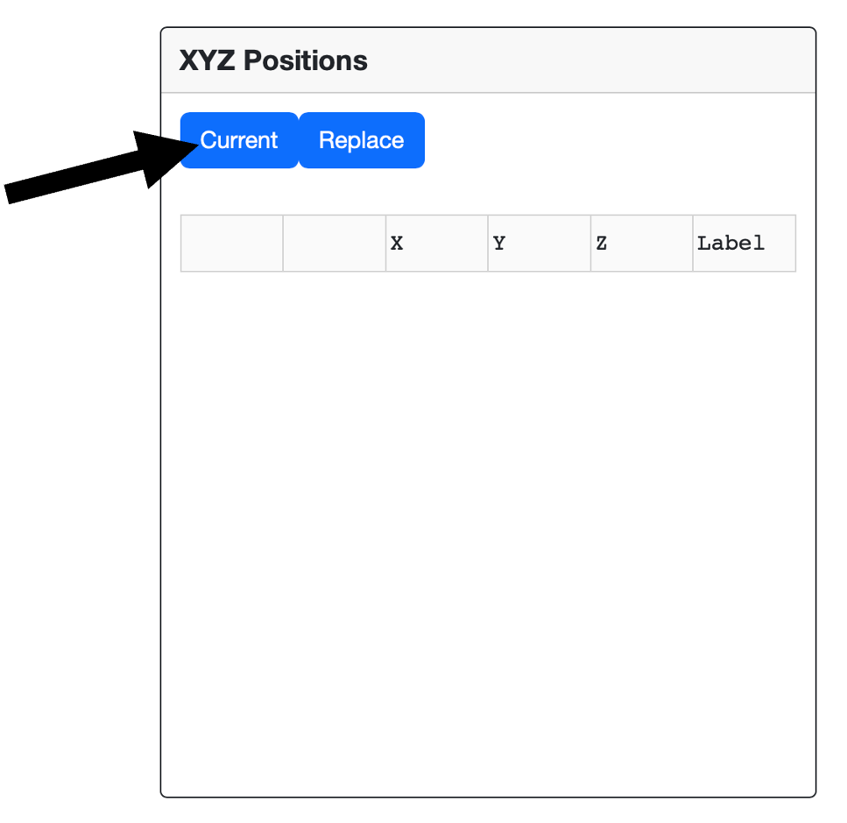
documentation/user_guide/assets/xyz-pos.png
