EmbryoPhenomics/LabEmbryoCam_V2/software/layout.py

import dash
from dash import dcc
import dash_daq as daq
from dash import html
from dash import dash_table
import dash_bootstrap_components as dbc

# Tab styles for ascending in hierarchy

tab_style = {
    'borderBottom': '1px solid #d6d6d6',
    'padding': '6px',
    'fontWeight': 'bold'
}

tab_selected_style = {
    'borderTop': '1px solid #d6d6d6',
    'borderBottom': '1px solid #d6d6d6',
    'backgroundColor': '#6E6E6E',
    'color': 'white',
    'padding': '6px'
}

tab_selected_style_sub_main = {
    'borderTop': '1px solid #d6d6d6',
    'borderBottom': '1px solid #d6d6d6',
    'backgroundColor': '#424242',
    'color': 'white',
    'padding': '6px'
}

tab_selected_style_main = {
    'borderTop': '1px solid #d6d6d6',
    'borderBottom': '1px solid #d6d6d6',
    'backgroundColor': '#848484',
    'color': 'white',
    'padding': '6px'
}

def app_layout(sensor_modes):
    camera_options = []
    for i,mode in enumerate(sensor_modes):
        w,h = mode['size']
        camera_options.append(dict(label=f'{w}x{h}', value=i))

    return html.Div(children=[

    html.Div(className='row', children=[
                html.Div(id='loaded-data-callback'),
                html.Div(id='hiddenFPSdata'),
                html.Div(id='fullROIData'),
                html.Div(id='config-save-callback'),
                html.Div(id='connect-cam-callback'),

                html.Div(className='row', children=[
                    html.Div(className='four columns', children=[

                        dbc.Card([
                            dbc.CardHeader('Experiment Settings', style={'font-weight': 'bold'}),
                            dbc.CardBody([
                                html.Div(children=[
                                    html.Div(children=[
                                        dbc.Button(id='load-config-button', size='lg', children='Load')
                                    ], style={'width': '10%', 'display': 'table-cell'}),

                                    html.Div(children=[
                                        dbc.Button('Save', id='save-config-button', size='lg')
                                    ], style={'width': '10%', 'display': 'table-cell'}),

                                    html.Div(children=[], style={'width': '80%', 'display': 'table-cell'}),
                                ], style={'width': '100%', 'display': 'table'}),
                            ])
                        ], style={'width': '35rem'}, color='dark', outline=True),

                        html.Br(),
                        
                        dbc.Card([
                            dbc.CardHeader('XYZ controls and settings', style={'font-weight': 'bold'}),
                            dbc.CardBody([
                                html.Div(children=[
                                    html.Div(children=[
                                        html.Br(),
                                        dbc.Button('Set Origin', id='home-xy-button', size='lg'),
                                        html.Div(id='xyz-homing-callback'),
                                        html.Div(id='xyz-homing-set-origin'),
                                    ], style={'width': '40%', 'display': 'table-cell'}),
                                    html.Div(children=[
                                        html.Br(),
                                    ], style={'width': '10%', 'display': 'table-cell'}),
                                    html.Div(children=[
                                        html.Label('Step-size:'),
                                        # dcc.Dropdown(
                                        #     id='xyz-magnitude',
                                        #     options=[
                                        #         dict(label='0.001mm', value=0.001),
                                        #         dict(label='0.01mm', value=0.01),
                                        #         dict(label='0.1mm', value=0.1),
                                        #         dict(label='1mm', value=1),
                                        #         dict(label='10mm', value=10)],
                                        #     value=10),

                                        html.Div(children=[
                                                dbc.RadioItems(
                                                    id="xyz-magnitude",
                                                    className="btn-group",
                                                    inputClassName="btn-check",
                                                    labelClassName="btn btn-outline-primary",
                                                    labelCheckedClassName="active",
                                                    options=[
                                                        {"label": "0.01mm", "value": 0.01},
                                                        {"label": "0.1mm", "value": 0.1},
                                                        {"label": "1mm", "value": 1},
                                                        {"label": "10mm", "value": 10},
                                                    ],
                                                    value=1,
                                        )], className="radio-group"),
                                    ], style={'width': '50%', 'display': 'table-cell'}),
                                ], style={'width': '100%', 'display': 'table'}),

                                html.Div(id='initial-xy'),

                                html.Div(children=[
                                    html.Br(),

                                    html.Div(className='row', children=[
                                        html.Div(className='eight columns', children=[
                                            html.Div(children=[
                                                html.Div(children=[
                                                    dbc.Button(html.I(className='fa-solid fa-square-arrow-up-right fa-flip-horizontal fa-2xl'), color='dark', size='lg', id='left-diag-xy-up'),
                                                ], style={'width': '33%', 'display': 'table-cell'}),
                                                html.Div(children=[
                                                    dbc.Button(html.I(className='fa-solid fa-arrow-up fa-2xl'), color='dark', size='lg', id='up-xy'),
                                                ], style={'width': '33%', 'display': 'table-cell'}),
                                                html.Div(children=[
                                                    dbc.Button(html.I(className='fa-solid fa-square-arrow-up-right fa-2xl'), color='dark', size='lg', id='right-diag-xy-up'),
                                                ], style={'width': '33%', 'display': 'table-cell'}),
                                            ], style={'width': '100%', 'display': 'table'}),

                                            html.Br(),

                                            html.Div(children=[
                                                html.Div(children=[
                                                    dbc.Button(html.I(className='fa-solid fa-arrow-left fa-2xl'), color='dark', size='lg', id='left-xy')
                                                ], style={'width': '33%', 'display': 'table-cell'}),
                                                html.Div(children=[
                                                    dbc.Label(children='XY-Axis', align='right'),
                                                ], style={'width': '33%', 'display': 'table-cell'}),
                                                html.Div(children=[
                                                    dbc.Button(html.I(className='fa-solid fa-arrow-right fa-2xl'), color='dark', size='lg', id='right-xy')
                                                ], style={'width': '33%', 'display': 'table-cell'}),
                                            ], style={'width': '100%', 'display': 'table'}),
                                            html.Br(),

                                            html.Div(children=[
                                                html.Div(children=[
                                                    dbc.Button(html.I(className='fa-solid fa-square-arrow-up-right fa-rotate-180 fa-2xl'), color='dark', size='lg', id='left-diag-xy-down')
                                                ], style={'width': '33%', 'display': 'table-cell'}),
                                                html.Div(children=[
                                                    dbc.Button(html.I(className='fa-solid fa-arrow-down fa-2xl'), color='dark', size='lg', id='down-xy')
                                                ], style={'width': '33%', 'display': 'table-cell'}),
                                                html.Div(children=[
                                                    dbc.Button(html.I(className='fa-solid fa-square-arrow-up-right fa-rotate-90 fa-2xl'), color='dark', size='lg', id='right-diag-xy-down')
                                                ], style={'width': '33%', 'display': 'table-cell'}),
                                            ], style={'width': '100%', 'display': 'table'}),
                                        ]),
                                        html.Div(className='four columns', children=[
                                            dbc.Button(html.I(className='fa-solid fa-arrow-up fa-2xl'), color='dark', size='lg', id='up-z'),
                                            html.Br(),
                                            html.Br(),
                                            dbc.Label(children='Z-Axis', align='right'),
                                            html.Br(),
                                            dbc.Button(html.I(className='fa-solid fa-arrow-down fa-2xl'), color='dark', size='lg', id='down-z'),
                                        ]),

                                        html.Div(children=[
                                            html.Div(id='left-diag-xy-up-div'),
                                            html.Div(id='up-xy-div'),
                                            html.Div(id='right-diag-xy-up-div'),

                                            html.Div(id='left-xy-div'),
                                            html.Div(id='right-xy-div'),

                                            html.Div(id='left-diag-xy-down-div'),
                                            html.Div(id='down-xy-div'),
                                            html.Div(id='right-diag-xy-down-div'),

                                            html.Div(id='up-z-div'),
                                            html.Div(id='down-z-div'),

                                        ])
                                    ])
                                ])
                            ])
                        ], style={'width': '35rem'}, color='dark', outline=True),

                        html.Br(),

                        dbc.Card([
                            dbc.CardHeader('XYZ Positions', style={'font-weight': 'bold'}),
                            dbc.CardBody([
                                html.Div(children=[
                                    html.Div(children=[
                                        dbc.Button('Current', id='grab-xy', size='lg'),
                                        html.Div(id='grab-xy-callback')
                                    ], style={'width': '40', 'display': 'table-cell'}),

                                    html.Div(children=[
                                        html.Br()
                                    ], style={'width': '20', 'display': 'table-cell'}),

                                    html.Div(children=[
                                        dbc.Button('Replace', id='replace-xy-button', size='lg'),
                                        html.Div(id='replace-xy-callback')
                                    ], style={'width': '40%', 'display': 'table-cell'}),

                                    html.Div(children=[], style={'width': '80%', 'display': 'table-cell'}),

                                ], style={'width': '100%', 'display': 'table'}),

                                html.Br(),

                                html.Div(id='remove-xy-callback'),
                                dash_table.DataTable(
                                    id='xy_coords',
                                    columns=[
                                        dict(name='X', id='x'), 
                                        dict(name='Y', id='y'), 
                                        dict(name='Z', id='z'),
                                        dict(name='Label', id='label')],
                                    style_cell={'textAlign': 'left'},
                                    style_cell_conditional=[{'if': {'column_id': col},'width': '20%'} for col in ['x','y','z']],
                                    fixed_rows={'headers': True},
                                    style_table={'height': 300},
                                    row_deletable=True,
                                    row_selectable='single',
                                    editable=True,
                                    page_size=300
                                )
                            ])
                        ], style={'width': '35rem'}, color='dark', outline=True),
                        
                        html.Br(),

                        dbc.Card([
                            dbc.CardHeader('Experiment setup', style={'font-weight': 'bold'}),
                            dbc.CardBody([
                                html.Label(children='Number of positions'),
                                dcc.RadioItems(
                                    id='acquisition-number',
                                    options=[
                                        {'label': 'Single', 'value': 'Single'},
                                        {'label': 'Multiple', 'value': 'Multiple'}],
                                    value='Single',
                                    labelStyle={'display': 'inline-block'}),

                                html.Div(id='acquisition-number-change'),

                                html.Br(),

                                html.Div(children=[
                                    html.Div(children=[
                                        html.Label(children='Number of time-points')
                                    ], style={'width': '70%', 'display': 'table-cell'}),
                                    html.Div(children=[
                                        daq.NumericInput(id='total-time-points', min=1, max=100000, value=1, size=100)
                                    ], style={'width': '30%', 'display': 'table-cell'}),
                                ], style={'width': '100%', 'display': 'table'}),

                                html.Div(id='total-time-points-change'),

                                html.Div(children=[
                                    html.Div(children=[
                                        html.Label(children='Acquisition interval (mins)')
                                    ], style={'width': '70%', 'display': 'table-cell'}),
                                    html.Div(children=[
                                        daq.NumericInput(id='acq-length', min=0, max=100000, value=1, size=100)
                                    ], style={'width': '30%', 'display': 'table-cell'}),
                                ], style={'width': '100%', 'display': 'table'}),

                                html.Div(id='acq-length-change'),

                                html.Div(children=[
                                    html.Div(children=[
                                        html.Label(children='Acquisition length (secs)')
                                    ], style={'width': '70%', 'display': 'table-cell'}),
                                    html.Div(children=[
                                        daq.NumericInput(id='each-time-limit', min=1, max=100000, value=1, size=100)
                                    ], style={'width': '30%', 'display': 'table-cell'}),
                                ], style={'width': '100%', 'display': 'table'}),

                                html.Div(id='each-time-limit-change'),

                                html.Br(),

                                html.Label('Drive and Folder selection:'),

                                html.Div(children=[
                                    html.Div(children=[
                                        dcc.Input(
                                            id='acquire-path-input', 
                                            type='text',
                                            placeholder='Specify a folder to save video for the drive selected...',),
                                    ], style={'width': '70%', 'display': 'table-cell'}),
                                    html.Div(children=[
                                        dbc.Button('Select', id='path-select', size='lg'),
                                    ], style={'width': '30%', 'display': 'table-cell'}),
                                ], style={'width': '100%', 'display': 'table'}),

                                html.Div(id='acquire-outpath-check'),
                                html.Div(id='acquire-path-input-change'),

                                html.Br(),

                                html.Div(children=[
                                    html.Div(children=[
                                        html.Label(children='Turn off light between timepoints:')
                                    ], style={'width': '50%', 'display': 'table-cell'}),
                                    html.Div(children=[
                                        daq.ToggleSwitch(
                                            id='light-auto-dimming',
                                            value=False,
                                            label=['Yes', 'No']),
                                    ], style={'width': '50%', 'display': 'table-cell'}),
                                ], style={'width': '100%', 'display': 'table'}),

                                # html.Div(children=[
                                #     html.Div(children=[
                                #         html.Label(children='Disk space (available/total)')
                                #     ], style={'width': '50%', 'display': 'table-cell'}),
                                #     html.Div(children=[
                                #         html.Label(id='disk_space_text')
                                #     ], style={'width': '50%', 'display': 'table-cell'}),
                                # ], style={'width': '100%', 'display': 'table'}),

                                # html.Br(),

                                # html.Div(children=[
                                #     html.Div(children=[
                                #         html.Label(children='Projected usage')
                                #     ], style={'width': '50%', 'display': 'table-cell'}),
                                #     html.Div(children=[
                                #         html.Label(id='projected_usage_text')
                                #     ], style={'width': '50%', 'display': 'table-cell'}),
                                # ], style={'width': '100%', 'display': 'table'}),

                                html.Br(),

                                dbc.Button('Start acquisition', id='acquire-button', size='lg'),
                                dbc.Button('Cancel acquisition', id='cancel-acquire-button', size='lg'),
                                html.Div(id='acquisition_state'),
                                html.Div(id='cancel_state'),
                                html.Div(id='acquisition_progress_state'),

                                dcc.Interval(id='acquisition_progress_interval', disabled=True),

                                dbc.Modal(
                                    [
                                        dbc.ModalHeader(dbc.ModalTitle("Acquisition Error")),
                                        dbc.ModalBody("Please cancel the live stream before starting an acquisition."),
                                    ],
                                    id="acquisition-live-stream-popup",
                                    is_open=False,
                                ),
                                dbc.Modal(
                                    [
                                        dbc.ModalHeader(dbc.ModalTitle("Acquisition Error")),
                                        dbc.ModalBody("Files already in folder, please change folder to not overwrite existing data."),
                                    ],
                                    id="acquisition-folder-popup",
                                    is_open=False,
                                ),
                                dbc.Modal(
                                    [
                                        dbc.ModalHeader(dbc.ModalTitle("Acquisition Error")),
                                        dbc.ModalBody("Time to scan per timepoint is greater than the interval requested. Please set a greater timepoint interval."),
                                    ],
                                    id="acquisition-interval-popup",
                                    is_open=False,
                                ),
                            ])
                        ], style={'width': '35rem'}, color='dark', outline=True),

                        html.Br(),
                    ]),
                    
                    #html.Div(className='one column', children=[]),

                    html.Div(className='seven columns', children=[

                        dbc.Card([
                            dbc.CardHeader('Camera View', style={'font-weight': 'bold'}),
                            dbc.CardBody([

                                html.Div(children=[
                                    html.Div(children=[

                                    dbc.Card([
                                        dbc.CardBody([

                                            dcc.Tabs(
                                                id='camera-settings-tabs',
                                                value='led-tab',
                                                children=[
                                                    dcc.Tab(label='LED', value='led-tab', style=tab_style, selected_style=tab_selected_style_main, children=[
                                                        html.Br(),
                                                        html.Label('Brightness of the LED ring.'),
                                                        dcc.Slider(
                                                            id='hardware-brightness',
                                                            min=0,
                                                            max=100,
                                                            value=0,
                                                            tooltip={'always_visible': True, 'placement': 'bottom'},
                                                            persistence=True),
                                                        html.Div(id='hardware-brightness-callback'),
                                                    ]),
                                                    dcc.Tab(label='Exposure', value='exposure-tab', style=tab_style, selected_style=tab_selected_style_main, children=[
                                                        html.Br(),
                                                        html.Label('Shutter speed for the camera sensor to use, in milliseconds.'),
                                                        dcc.Slider(
                                                            id='exposure',
                                                            min=0,
                                                            max=100,
                                                            value=20,
                                                            tooltip={'always_visible': True, 'placement': 'bottom'},
                                                            persistence=True),
                                                        html.Div(id='exposure-change'),
                                                    ]),
                                                    dcc.Tab(label='Gain', value='gain-tab', style=tab_style, selected_style=tab_selected_style_main, children=[
                                                        html.Br(),
                                                        html.Label('Analogue gain applied by the camera sensor.'),
                                                        dcc.Slider(
                                                            id='analogue_gain',
                                                            min=0,
                                                            max=20,
                                                            value=1,
                                                            tooltip={'always_visible': True, 'placement': 'bottom'},
                                                            persistence=True),
                                                        html.Div(id='analogue_gain-change'),
                                                    ]),                    
                                                    dcc.Tab(label='FPS', value='fps-tab', style=tab_style, selected_style=tab_selected_style_main, children=[
                                                        html.Br(),
                                                        html.Label('Frames per second the camera sensor delivers.'),
                                                        dcc.Slider(
                                                            id='fps',
                                                            min=0,
                                                            max=100,
                                                            value=30,
                                                            tooltip={'always_visible': True, 'placement': 'bottom'},
                                                            persistence=True),
                                                        html.Div(id='fps-change'),
                                                    ])
                                                ]),
                                                
                                                html.Br(),

                                                html.Div(children=[
                                                    html.Div(children=[
                                                        html.Label(children='Resolution'),
                                                        dcc.Dropdown(
                                                            id='resolution-preset',
                                                            placeholder='Please select a resolution...',
                                                            value=0,
                                                            options=camera_options,
                                                            disabled=False,
                                                            persistence=True,
                                                            persistence_type='session'),
                                                    ], style={'width': '50%', 'display': 'table-cell'}),

                                                    html.Div(children=[
                                                        html.Br(),
                                                    ], style={'width': '15%', 'display': 'table-cell'}),

                                                    html.Div(children=[
                                                        html.Br(),
                                                        dbc.Button('Update', id='update-camera-settings', size='lg'),
                                                        html.Div(id='hidden-update-callback'),
                                                    ], style={'width': '35%', 'display': 'table-cell'}),                                            
                                                ], style={'width': '100%', 'display': 'table'}),

                                                html.Div(id='resolution-preset-change'),

                                            ]),
                                        ])
                                    ], style={'width': '50%', 'display': 'table-cell'}),

                                    html.Div(children=[
                                        html.Br(),
                                    ], style={'width': '5%', 'display': 'table-cell'}),
                                    html.Div(children=[
                                        dbc.Card([
                                            dbc.CardBody([
                                               html.Br(),
                                                html.Label('Camera streaming mode'),
                                                daq.ToggleSwitch(
                                                    id='camera-streaming-mode',
                                                    value=False,
                                                    label=['Browser', 'Desktop']),

                                                html.Br(),

                                                html.Div(children=[
                                                    html.Div(children=[
                                                        dbc.Button('Snap', id='test-frame-button', size='lg')
                                                    ], style={'width': '30%', 'display': 'table-cell'}),
                                                    html.Div(children=[
                                                        dbc.Button('Start/Stop Stream', id='camera-live-stream', size='lg'),
                                                    ], style={'width': '60%', 'display': 'table-cell'}),
                                                    html.Div(children=[
                                                        html.Div(id='streaming-spinner')
                                                    ], style={'width': '`10%', 'display': 'table-cell'}),
                                                ], style={'width': '100%', 'display': 'table'}),
                                            ])
                                        ])
                                    ], style={'width': '45%', 'display': 'table-cell'})
                                ], style={'width': '100%', 'display': 'table'}),

                                html.Br(),

                                html.Div(children=[], id='camera-state-live-view'),
                                html.Div(children=[], id='camera-state-snapshot'),

                                dcc.Tabs(
                                    id='image-capture-tabs',
                                    value='still-tab',
                                    children=[
                                        dcc.Tab(label='Still Image', value='still-tab', style=tab_style, selected_style=tab_selected_style_main, children=[
                                            html.Div(id='still-image', children=[])
                                        ]),
                                        dcc.Tab(label='Live Stream', value='stream-tab', style=tab_style, selected_style=tab_selected_style_main, children=[
                                            html.Br(),
                                            html.Img(src="/video_feed")
                                        ])
                                    ]
                                ),
                                html.Div(id='image-capture-tab-state-still', children=[]),
                                html.Div(id='image-capture-tab-state-stream', children=[])
                            ])
                        ], style={'width': '80rem'}, color='dark', outline=True),

                        html.Br(),

                        dbc.Card([
                            dbc.CardHeader('XYZ View', style={'font-weight': 'bold'}),
                            dbc.CardBody([
                                html.Div(children=[
                                    html.Div(children=[
                                        html.Div(children=[
                                            html.Div(children=[
                                                html.Label('Activate graph')
                                            ], style={'width': '50%', 'display': 'table-cell'}),

                                            html.Div(children=[
                                                daq.BooleanSwitch(
                                                    id='activate-graph-switch',
                                                    on=False)
                                            ], style={'width': '50%', 'display': 'table-cell'})
                                        ], style={'width': '100%', 'display': 'table'}),

                                        html.Div(children=[
                                            html.Div(children=[
                                                html.Label('Dimensions')
                                            ], style={'width': '50%', 'display': 'table-cell'}),

                                            html.Div(children=[
                                                daq.ToggleSwitch(
                                                    id='dimensions-switch',
                                                    value=False,
                                                    label=['2D', '3D'])
                                            ], style={'width': '50%', 'display': 'table-cell'})
                                        ], style={'width': '100%', 'display': 'table'}),
                                    ], style={'width': '45%', 'display': 'table-cell'}),
                                    html.Div(children=[], style={'width': '10%', 'display': 'table-cell'}),
                                    html.Div(children=[
                                        html.Div(children=[
                                            html.Div(children=[
                                                dbc.Button('Generate xy', id='generate-xy-button', disabled=True, size='lg')
                                            ], style={'width': '40%', 'display': 'table-cell'}),
                                            html.Div(children=[
                                                dcc.Dropdown(
                                                    id='plate-size',
                                                    placeholder='Please select a plate size...',
                                                    options=[
                                                        dict(label='24 wells', value=24),
                                                        dict(label='48 wells', value=48),
                                                        dict(label='96 wells', value=96),
                                                        dict(label='384 wells', value=384)],
                                                    disabled=True)
                                            ], style={'width': '60%', 'display': 'table-cell'})
                                        ], style={'width': '100%', 'display': 'table'}),
                                        html.P('Note that you need position A1 to generate positions.'),
                                    ], style={'width': '45%', 'display': 'table-cell'}),
                                ], style={'width': '100%', 'display': 'table'}),

                                html.Div(id='generate-xy-callback'),
                                html.Div(id='load-xy-callback'),

                                html.Div(id='coord-graph-div', children=[]),      
                                html.Div(id='graph-xy-move'),
                            ])
                        ], style={'width': '80rem'}, color='dark', outline=True),

                    ]),
                ]),
            ]),

    html.Div(className='row', children=[
        dbc.Card([
            dbc.CardBody([
                html.H5('Experiment Progress:'),
                html.Div(children=[
                    html.Div(children=[
                        html.H6('Current timepoint:'),
                        html.H6('Current embryo:')
                    ], style={'width': '20%', 'display': 'table-cell'}),
                    html.Div(children=[
                        dbc.Progress(id="timepoint-pg", style={'height': '20px'}),
                        html.Br(),
                        dbc.Progress(id="embryo-pg", style={'height': '20px'})
                    ], style={'width': '80%', 'display': 'table-cell'}),
                ], style={'width': '100%', 'display': 'table'}),

                ])
            ])
        ]),
    ])
