EmbryoPhenomics/LabEmbryoCam_V2/software/ffmpegoutput.py

import signal
import subprocess

import prctl

from picamera2.outputs import Output


class FfmpegOutput(Output):
    """
    The FfmpegOutput class allows an encoded video stream to be passed to FFmpeg for output.

    This means we can take advantange of FFmpeg's wide support for different output formats.
    Optionally audio recording may be included, where this is handled entirely by FFmpeg.

    Because we are prepared to accept whatever parameters and values that FFmpeg supports,
    there is generally no checking up at this level. That may change over time as we
    develop better expectations as to what can and cannot work.

    For example, to record an mp4 file use FfmpegOutput("test.mp4")
    To include audio in the recording, use FfmpegOutput("test.mp4", audio=True)
    To record an MPEG2 transport stream, use FfmpegOutput("test.ts")
    In fact, the output filename may include any string of options and an output
    destination so long as these are meaningful to FFmpeg. So you might even try something
    like FfmpegOutput("-f mpegts udp://<ip-addr>:<port>").

    When audio recording is enabled, the following optional parameters are available:
    audio_device - the name of the Pulse audio device ("default" is usually OK)
    audio_sync - time offset (in seconds) to add to the audio stream to ensure synchronisation
    with the video. So making this more negative will make the audio earlier. In general this
    may need tweaking depending on the hardware and configuration being used.
    audio_samplerate, audio_codec, audio_bitrate - the usual audio parameters.
    """

    def __init__(self, output_filename, audio=False, audio_device="default", audio_sync=-0.3,
                 audio_samplerate=48000, audio_codec="aac", audio_bitrate=128000, pts=None):
        super().__init__(pts=pts)
        self.ffmpeg = None
        self.output_filename = output_filename
        self.audio = audio
        self.audio_device = audio_device
        self.audio_sync = audio_sync
        self.audio_samplerate = audio_samplerate
        self.audio_codec = audio_codec
        self.audio_bitrate = audio_bitrate
        # If we run an audio stream, FFmpeg won't stop so we'll give the video stream a
        # moment or two to flush stuff out, and then we'll have to terminate the process.
        self.timeout = 1 if audio else None
        # A user can set this to get notifications of FFmpeg failures.
        self.error_callback = None

    def start(self):
        general_options = ['-loglevel', 'warning',
                           '-y']  # -y means overwrite output without asking
        # We have to get FFmpeg to timestamp the video frames as it gets them. This isn't
        # ideal because we're likely to pick up some jitter, but works passably, and I
        # don't have a better alternative right now.
        video_input = ['-use_wallclock_as_timestamps', '1',
                       '-thread_queue_size', '256',  # necessary to prevent warnings
                       '-i', '-']
        video_codec = ['-c:v', 'copy']
        audio_input = []
        audio_codec = []
        if self.audio:
            audio_input = ['-itsoffset', str(self.audio_sync),
                           '-f', 'pulse',
                           '-sample_rate', str(self.audio_samplerate),
                           '-thread_queue_size', '1024',  # necessary to prevent warnings
                           '-i', self.audio_device]
            audio_codec = ['-b:a', str(self.audio_bitrate),
                           '-c:a', self.audio_codec]

        command = ['ffmpeg'] + general_options + audio_input + video_input + \
            audio_codec + video_codec + self.output_filename.split()
        # The preexec_fn is a slightly nasty way of ensuring FFmpeg gets stopped if we quit
        # without calling stop() (which is otherwise not guaranteed).
        self.ffmpeg = subprocess.Popen(command, stdin=subprocess.PIPE, preexec_fn=lambda: prctl.set_pdeathsig(signal.SIGKILL))
        super().start()

    def stop(self):
        super().stop()
        if self.ffmpeg is not None:
            self.ffmpeg.stdin.close()  # FFmpeg needs this to shut down tidily
            try:
                # Give it a moment to flush out video frames, but after that make sure we terminate it.
                self.ffmpeg.wait(timeout=self.timeout)
            except subprocess.TimeoutExpired:
                # We'll always end up here when there was an audio strema. Ignore any further errors.
                try:
                    self.ffmpeg.terminate()
                except Exception:
                    pass
            self.ffmpeg = None

    def outputframe(self, frame, keyframe=True, timestamp=None):
        if self.recording and self.ffmpeg:
            # Handle the case where the FFmpeg prcoess has gone away for reasons of its own.
            try:
                self.ffmpeg.stdin.write(frame)
                self.ffmpeg.stdin.flush()  # forces every frame to get timestamped individually
            except Exception as e:  # presumably a BrokenPipeError? should we check explicitly?
                self.ffmpeg = None
                if self.error_callback:
                    self.error_callback(e)
            else:
                self.outputtimestamp(timestamp)
