EmbryoPhenomics/LabEmbryoCam_V2/(commit log)

2023-11-08 Migration of code from labep_interface_embedded
    [back_corner_knob(2).stl, back_motion_corner_left_smallbody.stl, back_motion_corner_mainbody_left.stl, back_motion_corner_mainbody_right.stl, back_motion_corner_right_smallbody.stl, bottom_corner_bracket(2).stl, bottom_corner_bracket_mirror(2).stl, cable vibration dampener bottom.stl]
2023-11-08 documentation updates
    [bed.g, config.g, homeall.g, homex.g, homey.g, homez.g, multiwell_24_19.csv, multiwell_384_4.5.csv]
2023-11-10 Fix xyz homing.
    [homeall.g]
2023-11-10 Finishing up.
    [multiwell_24_19.csv, multiwell_384_4.5.csv, multiwell_48_13.csv]
2023-11-17 Minor fixes for xyz control and position generation.
    [app.py]
2023-11-17 Update LED script.
2023-12-04 Updated steps per mm in config.g
    [config.g]
2023-12-05 General repo update and cleanup.
    [bed.g, config.g, homeall.g, homex.g, homey.g, homez.g, pause.g, resume.g]
2023-12-08 Fix bug surrounding rgb video capture.
    [app.py, camera_backend_picamera2.py]
2024-01-10 Minor bug fixes and alterations to camera behaviour on picamera2
    [app.py, camera_backend_picamera2.py, layout.py]
2024-02-23 Refactor codebase.
    Picamera2 now used with full sensor modes \n Dynamic changes to exposure and fps \n Create acquisition pipeline API separate from app.py for use with testing \n Add ffmpeg file output using mkv.
2024-02-26 Increase y soft limit and add wait before retrieving positional information after setting stage origin.
2024-02-26 Remove faulty encoding function and revert to default.
    [camera_backend_picamera2.py]
2024-02-26 Correct y direction in homing sequence.
    [homeall.g]
2024-02-29 Disable homing button during homing sequence.
2024-02-29 Add array flipping to mjpeg encoder.
    [camera_backend_picamera2.py]
2024-02-29 Increase queue size to prevent thread queue warnings with official picamera2 implementation.
    [ffmpegoutput.py]
2024-02-29 Remove test acquisition button.
2024-03-01 Correct steps per mm.
    [config.g]
2024-03-05 Add analogue gain to camera capture.
2024-03-05 Single picamera2 instance is used throughout, fixing issues with v4l2 when repeatedly opening/closing the picamera2 class.
    [camera_backend_picamera2.py]
2024-03-05 Add analogue gain and labels for each tunable camera parameter.
2024-03-05 Fix position retrieval for Duet3D.
    [xyz.py]
2024-06-18 Add scan time check to prevent impossible experiments.
    [app.py, camera.py, camera_backend_picamera2.py, capture_mjpeg.py, layout.py, xyz.py]
